JSantiagoGR/AquaHuerto-Escolar/epanet/3/reporte/img/F02_cajon_subida_y_cruz.jpg

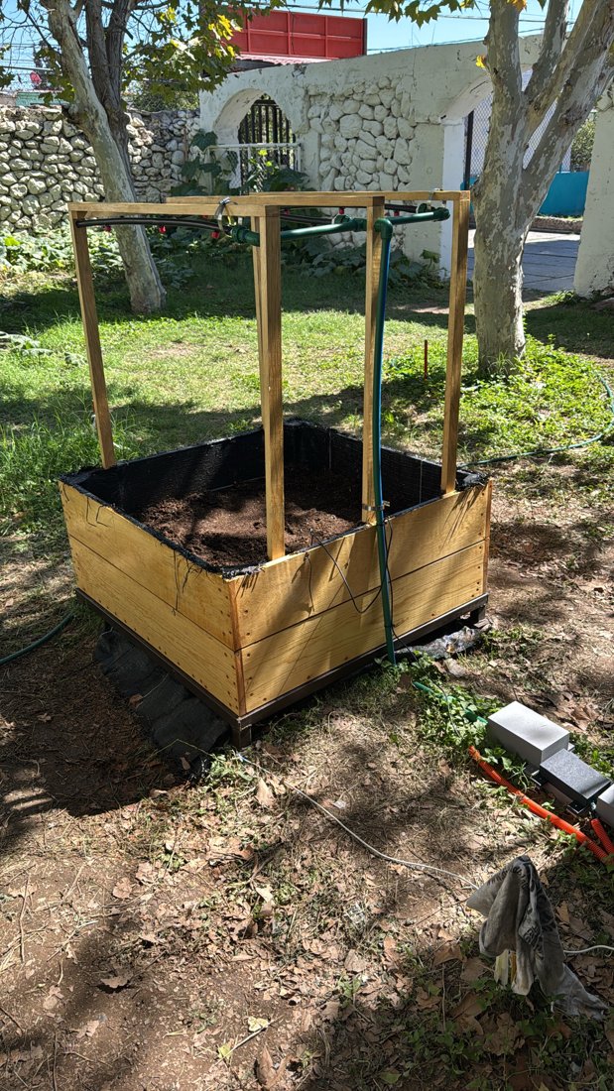
epanet/3/reporte/img/F02_cajon_subida_y_cruz.jpg
