JSantiagoGR/AquaHuerto-Escolar/epanet/1/datos_pendientes_validacion_final.md

# Datos pendientes para la validación final del modelo EPANET

El modelo `riego_huerto_final.inp` ya es ejecutable, pero sus **presiones** son preliminares. Estos datos deben medirse u obtenerse físicamente. Ordenados por impacto.

| # | Dato | Por qué importa | Cómo obtenerlo | Dónde se usa en EPANET |
|---|---|---|---|---|
| 1 | **Curva Q‑H real de la bomba** (≥ 3 puntos) | Fija la altura disponible y todas las presiones. La curva actual es PROVISIONAL. | Hoja técnica del fabricante; si no existe, **ensayo**: con la bomba a 12 V, medir caudal (probeta + cronómetro o YF‑S201) a varias presiones de descarga reguladas con una válvula de bola y un manómetro (0, 1, 2, 3 … bar hasta que corte el presostato). Registrar también el voltaje real. | `[CURVES]` → sustituir `PUMP_CURVE_PROVISIONAL` por `PUMP_CURVE_REAL` y actualizar `[PUMPS] PU1`. |
| 2 | **Modelo exacto de la bomba** | Permite buscar la curva certificada y la presión de arranque/corte del presostato. | Etiqueta completa, caja, factura o proveedor; número de modelo en el cuerpo o la cabeza de la bomba. | Documentación; fuente de la curva (#1). |
| 3 | **Nivel hidráulico del agua en el tinaco** (mín./máx.) | Es la altura de partida (Head de R1). | Medir con flexómetro la cota de la superficie del agua respecto a un datum común (p. ej., el suelo), con tinaco lleno y en nivel mínimo de operación. | `[RESERVOIRS] R1 Head` (o `[TANKS]` si se quiere modelar el vaciado). |
| 4 | **Altura del tinaco / de su salida** | Define la succión de la bomba (bomba autocebante ≈ 2.5 m según anuncios, no verificado). | Medir la cota de la salida del tinaco y de la bomba respecto al mismo datum. | Elevación de `J-PUMP` y Head de `R1`. |
| 5 | **Elevación del cajón** (superficie y goteros) | Determina la presión real en los goteros. | Medir cota de los laterales respecto al datum común. | `[JUNCTIONS]` Elev de `J-H`, `L1…L4` (y `E11…E46`). |
| 6 | **Diferencia de altura tinaco‑cajón** | Resume #3–#5; la presión en goteros cambia 1 m por cada metro de desnivel. | Resta de las cotas anteriores (o nivel de manguera con agua). | Diferencia entre `R1 Head` y Elev de nodos del cajón. |
| 7 | **Diámetro interior real de la manguera principal** | hf ∝ D^‑4.87: 1 mm menos en 12.7 mm aumenta la pérdida ≈ 50 % ((12.7/11.7)^4.87 = 1.49). Ahora se usa 12.7 mm nominal. | Calibrador vernier en un corte limpio (medir 2 direcciones y promediar) o especificación del fabricante. | `[PIPES] P-MAIN` Diam (mm); también `V1`. |
| 8 | **Diámetro interior real de la manguera de 16 mm** | “16 mm” es diámetro exterior nominal; el interior suele ser menor. | Vernier en un corte, o ficha técnica (espesor de pared). | `[PIPES] P-HEADER`, `PL1…PL4` (y segmentos del modelo 24). |
| 9 | **Pérdida hidráulica del YF‑S201** | Puede superar a toda la fricción de tuberías (≈ 1 cm calculado). | Ficha del sensor (curva ΔP‑Q) o ensayo: manómetro diferencial / dos manómetros antes y después a 1.6 L/min. Convertir a K = 2gΔh/V². | Añadir tramo corto o `MinorLoss` en el enlace aguas abajo de `J-FLOW`, o una TCV con K. |
| 10 | **Cv / Kv / K de la electroválvula** | Pérdida localizada en riego; hoy se modela como K = 0. | Hoja técnica (Kv en m³/h a 1 bar). K = 2g·(ΔP/ρg)/V² o desde Kv: ΔP[bar] = (Q[m³/h]/Kv)². Verificar también su **presión mínima de apertura** (muchas NC piloteadas requieren ≈ 0.2–0.5 bar; confirmar en la ficha). | Convertir `V1` en TCV con `Setting = K`, o `MinorLoss` en `V1`. |
| 11 | **Curva presión‑caudal de los goteros** | Los goteros reales cambian su caudal con la presión (salvo autocompensados). Con demandas fijas no se ve este efecto. | Ficha del gotero; o ensayo: recoger volumen de varios goteros en 5–10 min a 2–3 presiones distintas. | Define si se usan demandas fijas o emisores. |
| 12 | **Emitter coefficient de los goteros** | Permite simular goteros dependientes de presión: q = K·p^x. | De #11: ajustar K y x (EPANET usa `Emitter Exponent`, por defecto 0.5). Por gotero en L/s y m. | `[EMITTERS]` en `E11…E46` (modelo 24) y `[OPTIONS] Emitter Exponent`; eliminar la demanda fija. |
| 13 | Presión máxima admisible de goteros, conectores y manguera | Con la curva provisional la presión estimada es ≈ 67 m (≈ 6.6 bar); hay que confirmar si el sistema la resiste o requiere regulador. | Fichas técnicas de manguera, conectores y gotero. | Criterio de aceptación de resultados; eventual PRV en EPANET. |
| 14 | Pérdidas en accesorios (tee, adaptador 1/2 in → 16 mm, conectores de arranque) | Pérdidas menores no incluidas. | Tablas de K del fabricante o bibliografía de accesorios. | `MinorLoss` de los tramos correspondientes. |
| 15 | Caudal real medido con el YF‑S201 durante el riego | Validación final: comparar con 1.60 L/min del modelo. | Registro del ESP32 (pulsos/ s → L/min con el factor de calibración del sensor) y prueba volumétrica. | Comparación con Flow de `P-MAIN`. |

**Al recibir los datos:** editar el `.inp`, ejecutar `python validar_modelo.py riego_huerto_final.inp` y actualizar `calculos_hidraulicos.md` y `validacion_epanet.txt`.
