JSantiagoGR/AquaHuerto-Escolar/epanet/2/DECISIONS.md

# Decisiones de modelado y diseño

| # | Decisión | Motivo | Alternativa descartada |
|---|---|---|---|
| D1 | **DI = 14.40 mm** para todo el Tuboplus | Catálogo oficial Tuboplus 200224 (Clase 16, SDR 7.4) y Tabla 11 (v = 0.31 m/s a 0.05 L/s) lo confirman | 12.7 mm (“1/2"” nominal) |
| D2 | **Darcy‑Weisbach** (ε = 0.007 mm) como fórmula principal en EPANET | Los caudales son bajos: turbulento bajo (Re 4900–6500), transición (≈3200) y laminar (≈1600). H‑W no es válida en laminar/transición | H‑W (se reporta solo como comparación, C = 150) |
| D3 | Los 4 SD‑B como **EMITTERS individuales** (E1–E4), Q = C·Pⁿ con **n = 0.5827** ajustado a la tabla oficial de Hunter y C anclado en 50 L/h @ 1.5 bar | Hunter publica 3 puntos P‑Q (máximo ajuste) suficientes para el ajuste; no publica n | Una demanda equivalente; n = 0.5 como dato (se deja solo como escenario SUPUESTO) |
| D4 | Escenario adicional con **demanda fija** 50 L/h por aspersor | Obtener las pérdidas en el caudal de diseño y la **altura requerida de bomba (15.04 m a 0.0556 L/s)** sin depender de la curva provisional | — |
| D5 | **Check** = Pipe con **Status CV** (J‑TK → J‑CHK), K = 2.7 ESTIMADO | Es la representación EPANET de una válvula de retención; el sentido impide flujo bomba → tinaco | Válvula de control EPANET (no existe tipo “check”) |
| D6 | **Electroválvula** = Pipe ON/OFF (Status OPEN en riego) con K desde Kv = 3 (ESTIMADO) | Permite representar abierto/cerrado y una pérdida explícita; en v1 una TCV con K = 0 causó desbalance numérico | TCV con K inventado como real |
| D7 | **YF‑S201** = Pipe de D = 11 mm (DI documentado), L = 62 mm, K = 2.0 ESTIMADO | Representa la contracción del cuerpo; no hay curva ΔP‑Q del fabricante | Junction sin pérdida (v1) |
| D8 | Rama de cada aspersor = Pipe 30 mm, D = 4 mm (paso de la espiga de 6 mm, ESTIMADO), K = 1.0 | No ignorar el adaptador T‑rosca → espiga; es la mayor pérdida menor individual (0.139 m) | Conectar el emisor directamente al lateral |
| D9 | K de conexiones **oficiales Tuboplus (Tabla 10)**, asignados al enlace que entra a la conexión; T principal = tipo 8 (entra por derivación, sale por ambos lados, 2.20); T de aspersor = tee de rosca central (0.80) | Valores del fabricante | Convertir conexiones en “metros equivalentes de tubo” |
| D10 | **Bomba con curva PUMP_CURVE_PROVISIONAL** (la misma de v1: 91.91 m a Q = 0 → 0 m a 0.1 L/s, lineal) + sensibilidad ×0.25…×0.75 + altura requerida | No existe curva Q‑H verificable. **NO** se usa “6 L/min a 0.9 MPa” como punto simultáneo: 0.9 MPa se interpreta solo como corte del presostato a Q ≈ 0 | Inventar una curva “real” |
| D11 | Tinaco = **Reservoir** con Head = nivel de agua (1.19 m tinaco lleno); escenario con 0.30 m | Régimen permanente de riego; el tinaco se cambiará: todo se parametriza en `CONFIG["tinaco"]` | Tank (no aporta en estado estacionario) |
| D12 | Geometría: bomba cerca del tinaco (X ≈ 0.55 m), succión corta e inundada; subida a 5 cm del cajón; T dentro del cajón a 3 cm del borde | Succión corta y positiva (1.0 m) favorece el cebado; deja la línea principal en un solo tramo de 2.747 m | Bomba junto al cajón (succión larga) |
| D13 | Laterales **terminan en la T del aspersor B + niple 40 mm + tapón** (lateral c‑c ≈ 0.72 m, no 1.0 m) | Evita un tramo muerto de agua estancada sin aspersores y ahorra Tuboplus; los aspersores quedan en 0.25/0.75 m como se pidió | Prolongar el lateral hasta 1.0 m |
| D14 | Elevaciones: laterales +0.53 (sobre la tierra del cajón), boquilla +0.56 | Nivel de riego +0.52 dado por el equipo + radio del tubo + ~3 cm de tee/adaptador | — |
| D15 | Modelo **paramétrico** (`generar_modelo.py`, bloque CONFIG) | Permite sustituir tinaco, aspersor, curva de bomba, K y geometría y regenerar todo | Editar el .inp a mano |
| D16 | El servidor MCP se ejecutó con directorio de trabajo en una carpeta temporal | El servidor crea `Networks/` y `Modified/` en su directorio de trabajo; así no se modificaron las carpetas 1 ni 2 | Copiar archivos a la carpeta 1 |
| D17 | Capturas: `00_Modelo_Limpio.png` es captura **real** de la GUI de EPANET 2.2 (abierta por línea de comandos, captura de ventana sin interacción). Las vistas de resultados se generaron con Python (`*_PYTHON.png`) | En esta sesión no estaba disponible el control de la interfaz para pulsar Run Analysis ni cambiar vistas; no se inventan capturas | — |
| D18 | Filtro ≥ 100 mesh / 150 µm en el **esquema físico** (descarga de la bomba, antes del YF‑S201) y en el BOM, pero **no** en el modelo hidráulico base; el regulador tampoco | Hunter exige esa filtración; el modelo de filtro y su K no se conocen aún. Ubicado aguas abajo de la bomba para no añadir pérdida en la succión y proteger YF‑S201, electroválvula y SD‑B | Filtro antes de la bomba (pérdida en la succión de una bomba de diafragma) |
| D19 | Caudales de SD‑B fuera de 1.0–2.0 bar se reportan como **EXTRAPOLACIÓN DEL MODELO** (columna `nota` en los CSV y aviso del validador) | La tabla oficial de Hunter termina en 2.0 bar; 0.5–2.5 bar es solo el rango general de funcionamiento | Presentar 65.9 L/h como dato del aspersor |
| D20 | Se mantiene la distribución 0.25/0.75 m y se agrega un **escenario de cobertura r ≈ 0.36 m** (S9/S10) con presión obtenida por **interpolación** de la tabla oficial (≈ 1.80 bar, ≈ 56 L/h) | r = 0.30 m deja sin cubrir 9 puntos a 0.354 m; cambiar la distribución sin datos de campo no se justifica | Mover aspersores o inventar una relación radio‑presión |
