JSantiagoGR/AquaHuerto-Escolar/epanet/2/SOURCES.md

# Fuentes consultadas

Prioridad aplicada: fabricante > manual oficial > literatura técnica > otras fuentes. Consultadas entre el 29 y el 30 de septiembre de 2026.

| # | Fuente (URL) | Dato utilizado | Uso en el proyecto | Clase |
|---|---|---|---|---|
| 1 | Rotoplas, *Manual Técnico Tuboplus* (ed. 2017) — https://ferreambriz.com/wp-content/uploads/2024/08/MANUAL-TUBOPLUS.pdf | Catálogo de tubos: código **200224**, d 20, **di 14.40 mm, e 2.80 mm, área 1.63 cm²**; marcado “Clase 16 (SDR 7.4)”; **rugosidad 0.007 mm**; viscosidad 1.02×10⁻⁶ m²/s; **Tabla 10 de coeficientes K** (codo 90° 2.00, tee 1.8/1.3/4.2/2.2, tee rosca central 0.80, conector 0.40, reducción 0.55/0.85, cople 0.25); **Tabla 11** (0.05 L/s → j 0.013 m/m, v 0.31 m/s); dimensiones de codo 200014, tee 200178, tee rosca central 2000166, conector 200039/200051, tuerca unión mixta 200235, tapón 200155 | Diámetro interior en EPANET, rugosidad D‑W, K de conexiones, cortes y validación cruzada de la fórmula de fricción | OFICIAL (manual del fabricante; copia alojada por distribuidor) |
| 2 | Rotoplas Centroamérica, *Tuboplus Hidráulico (PP‑R) — Especificaciones técnicas* — https://rotoplascentroamerica.com/tuboplus/rtp-resources/descargas/Final_Ficha_Tecnica_Tuboplus_Impresioon.pdf | 24 kg/cm² a 20 °C; tiempos de termofusión 20 mm (12 s / 4 s / 2 min); presiones admisibles | BOM (instalación), límite de presión | OFICIAL |
| 3 | Rotoplas México, producto “Tubo clase 16 de 20 mm” — https://rotoplas.com.mx/product/Tubo-clase-16-de-20-mm-Tuboplus/ | SKU **200224**, clase 16, 20 mm (1/2") | Confirma que el tubo comercial de 1/2" es el código del catálogo con DI 14.40 mm | OFICIAL |
| 4 | Ficha técnica Tuboplus (conducción de agua) — https://pprmexico.com/wp-content/uploads/2025/02/tuboplus-ficha-tecnica.pdf | Conectores con inserto (20 × 1/2", NPT), tuercas unión plásticas, par máx. 16 N·m | BOM / instalación | OFICIAL (alojada por distribuidor) |
| 5 | Hunter Industries, *Micro Sprays Product Cutsheet (Metric)* — https://www.hunterirrigation.com/sites/default/files/CA-Cutsheet-Micro-Sprays-EM.pdf | Solo‑Drip: 1.0 bar 0–40 L/h Ø0–0.5 m; **1.5 bar 0–50 L/h Ø0–0.6 m**; 2.0 bar 0–60 L/h Ø0–0.8 m; ajustable (~20 clics); **entrada espiga 6 mm**; **rango 0.5–2.5 bar**; **filtración mínima 100 mesh / 150 µm** | Escenario de diseño (50 L/h a 1.5 bar), ajuste del emisor Q = C·Pⁿ, verificación de rango, filtro en BOM | OFICIAL |
| 6 | Hunter, *Micro Sprays Performance Charts* (métrico) — https://www.hunterirrigation.com/en-metric/node/32276 ; (US) https://www.hunterirrigation.com/node/32276 | Misma tabla de desempeño (US: 15/20/30 psi → 11/12.5/15.7 GPH) | Confirmación cruzada | OFICIAL |
| 7 | Hunter, página del SD‑B — https://www.hunterirrigation.com/en-metric/irrigation-product/micro-sprays/sd-b | SKU **SDB**, “Barb, 360°”, UPC 0611698156742 | Identificación del modelo provisional | OFICIAL |
| 8 | Handson Technology, *YF‑S201B Water Flow Sensor User Guide* — https://handsontec.com/dataspecs/sensor/Water%20Flow%20Sensor.pdf | **DI 11 mm**, DE 20 mm, 1–30 L/min, presión de prueba < 1.75 MPa, 450 pulsos/L, ±5 % (2–30 L/min) | D del enlace YF en EPANET; rango de operación | DOC. TÉCNICA de distribuidor (no hay fabricante identificado) |
| 9 | Ficha YF‑S201 (distribuidor) — https://fabacademy.org/2025/labs/dilijan/students/zhirayr-ghukasyan/files/Week09/YF-S201.PDF | F (Hz) = 7.5·Q (L/min); presión máx. 2.0 MPa; conexiones 1/2" | Frecuencia esperada (25 Hz a 3.33 L/min) | DOC. TÉCNICA de distribuidor |
| 10 | Anuncios comerciales de la bomba (eBay https://www.ebay.com/itm/296626432825 ; AliExpress https://www.aliexpress.com/item/1005005564374311.html ; Amazon/Walmart) | Solo repiten la placa: 12 V, 6 A, 72 W, 6 L/min, 0.9 MPa; **ninguno publica curva Q‑H** | Justifica que la curva es PROVISIONAL; **no** se usó como curva | COMERCIAL (no confiable para curva) |
| 11 | Crane Co., *Flow of Fluids Through Valves, Fittings, and Pipe*, Technical Paper 410 | K de válvula check de columpio = 100·f_T; f_T(1/2") = 0.027 → **K ≈ 2.7**; check de elevación K = 600·f_T ≈ 16.2; entrada de borde vivo K = 0.5 | K ESTIMADO de la check y de la salida del tinaco; rango de sensibilidad | LITERATURA TÉCNICA |
| 12 | IEC 60534 / VDI/VDE 2173 (definición de Kv) | Kv = Q[m³/h] a Δp = 1 bar → Δp = (Q/Kv)² | Conversión Kv → K de la electroválvula | NORMA / LITERATURA |
| 13 | U.S. EPA, *EPANET 2.2 User Manual* (EPA/600/R‑20/133) — https://www.epa.gov/system/files/documents/2021-07/epanet_users_manual_2.2.0-1.pdf | Formato .INP, unidades LPS, D‑W con interpolación en transición, emisores Q = C·pⁿ (exponente global), Pipe con Status CV (check) | Construcción del modelo | OFICIAL |
| 14 | OpenWaterAnalytics EPANET / EPyT — https://github.com/OpenWaterAnalytics/EPANET , https://github.com/OpenWaterAnalytics/EPyT | Toolkit 2.3.5 (doble precisión) | Escenarios y validación cruzada | OFICIAL (código abierto) |
| 15 | USEPA / Sandia WNTR 1.5 — https://github.com/USEPA/WNTR | Parser + EpanetSimulator v2.2 | Validación, grafo, figuras | OFICIAL (código abierto) |
| 16 | KWR‑Water, *epanet-mcp-server* — https://github.com/KWR-Water/epanet-mcp-server | Servidor MCP “EPANET Simulation Server” 1.30.0 | Simulación vía MCP (validación adicional) | Código abierto |
| 17 | Swamee & Jain (1976), *J. Hydraulics Div. ASCE* 102(5); Colebrook (1939) | Ecuaciones de factor de fricción | Cálculo manual | LITERATURA |
| 18 | Material de clase `Epanet 2.pptx` (carpeta 1 / Descargas) | Fórmulas H‑W, D‑W, Re, Moody, LPS | Método de cálculo | CLASE |
