JSantiagoGR/AquaHuerto-Escolar/documentacion/EXPOSICION_AquaHuerto/00_Indice_general.docx

AQUAHUERTO ESCOLAR

Índice general de la carpeta

Dónde está cada documento solicitado

Sistema mecatrónico de riego inteligente para huertos escolares

Escuela Primaria Federal Belisario Domínguez · Chihuahua, Chihuahua

Equipo 2 · Tecnológico de Monterrey, Campus Chihuahua

Jaime Santiago Galaviz Reaza

Victor Manuel Palicio Torres

Eyra Cristal Garcia

Noviembre de 2026

# Contenido de la carpeta

# | Documento | Carpeta

1 | Anteproyecto de Ingenierías (Anexo 2) | 1_Documentos_principales/01_Anteproyecto_Anexo2
2 | Bitácora del proyecto | 1_Documentos_principales/02_Bitacora_del_proyecto
3 | Cartel científico | 1_Documentos_principales/03_Cartel_cientifico
4 | Bibliografía y referencias | 1_Documentos_principales/04_Bibliografia_y_referencias
5 | Memoria técnica | 2_Documentacion_tecnica/05_Memoria_tecnica (+ reporte y manuales técnicos)
6 | Planos y modelos CAD | 2_Documentacion_tecnica/06_Planos_CAD (+ modelos 3D: SolidWorks, STEP, STL y Blender)
7 | Diagramas hidráulicos | 2_Documentacion_tecnica/07_Diagramas_hidraulicos
8 | Simulaciones de EPANET | 2_Documentacion_tecnica/08_EPANET (+ modelo .inp y resultados)
9 | Diagrama eléctrico y electrónico | 2_Documentacion_tecnica/09_Diagrama_electrico
10 | Especificaciones de componentes | 2_Documentacion_tecnica/10_Especificaciones_componentes
11 | Diagramas de flujo y arquitectura | 2_Documentacion_tecnica/11_Diagramas_flujo_y_arquitectura
12 | Firmware ESP32 y modos | 2_Documentacion_tecnica/12_Firmware_ESP32
13 | Dashboard, MQTT, Node-RED y Raspberry Pi | 2_Documentacion_tecnica/13_Dashboard_MQTT_NodeRED_RaspberryPi
14 | Modelo de IA predictiva | 2_Documentacion_tecnica/14_Modelo_IA
15 | Calibración de sensores | 2_Documentacion_tecnica/15_Calibracion_sensores
16 | Pruebas físicas | 2_Documentacion_tecnica/16_Pruebas_fisicas (+ datos crudos)
17 | Comparación contra objetivos | 2_Documentacion_tecnica/17_Comparacion_contra_objetivos
18 | Riesgos y seguridad | 2_Documentacion_tecnica/18_Analisis_de_riesgos
19 | Fotografías del proceso | 2_Documentacion_tecnica/19_Fotografias
20 | Cartel para imprimir | 3_Exhibicion/20_Cartel_para_imprimir
21 | Bitácora para evaluadores | 3_Exhibicion/21_Bitacora_para_evaluadores
22 | Demostración segura | 3_Exhibicion/22_Demostracion_segura
23 | Fotografías, gráficas y videos | 3_Exhibicion/23_Fotos_graficas_y_videos
24 | Explicación oral de 15 minutos | 3_Exhibicion/24_Explicacion_oral_15_min

Cada documento está en Word (para editar) y en PDF (para imprimir o entregar).

# Lo que deben agregar ustedes

- Videos del riego real y de la demostración (carpeta 23).
- Fotos de la construcción que tengan en sus celulares (carpeta 19).
- Si la convocatoria da un formato oficial del Anexo 2 o medidas del cartel distintas a 90 × 120 cm, pasar el contenido a ese formato.

AquaHuerto · Índice general de la carpeta · Página
