JSantiagoGR/AquaHuerto-Escolar/documentacion/EXPOSICION_AquaHuerto/2_Documentacion_tecnica/06_Planos_CAD/modelos_3D/renders/bomba_de_cerca.png

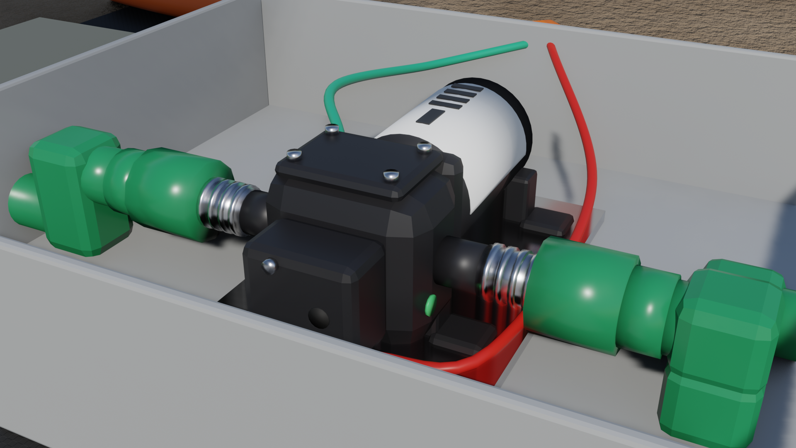
documentacion/EXPOSICION_AquaHuerto/2_Documentacion_tecnica/06_Planos_CAD/modelos_3D/renders/bomba_de_cerca.png
