JSantiagoGR/AquaHuerto-Escolar/documentacion/EXPOSICION_AquaHuerto/2_Documentacion_tecnica/08_EPANET/capturas/fig_epanet_presiones.png

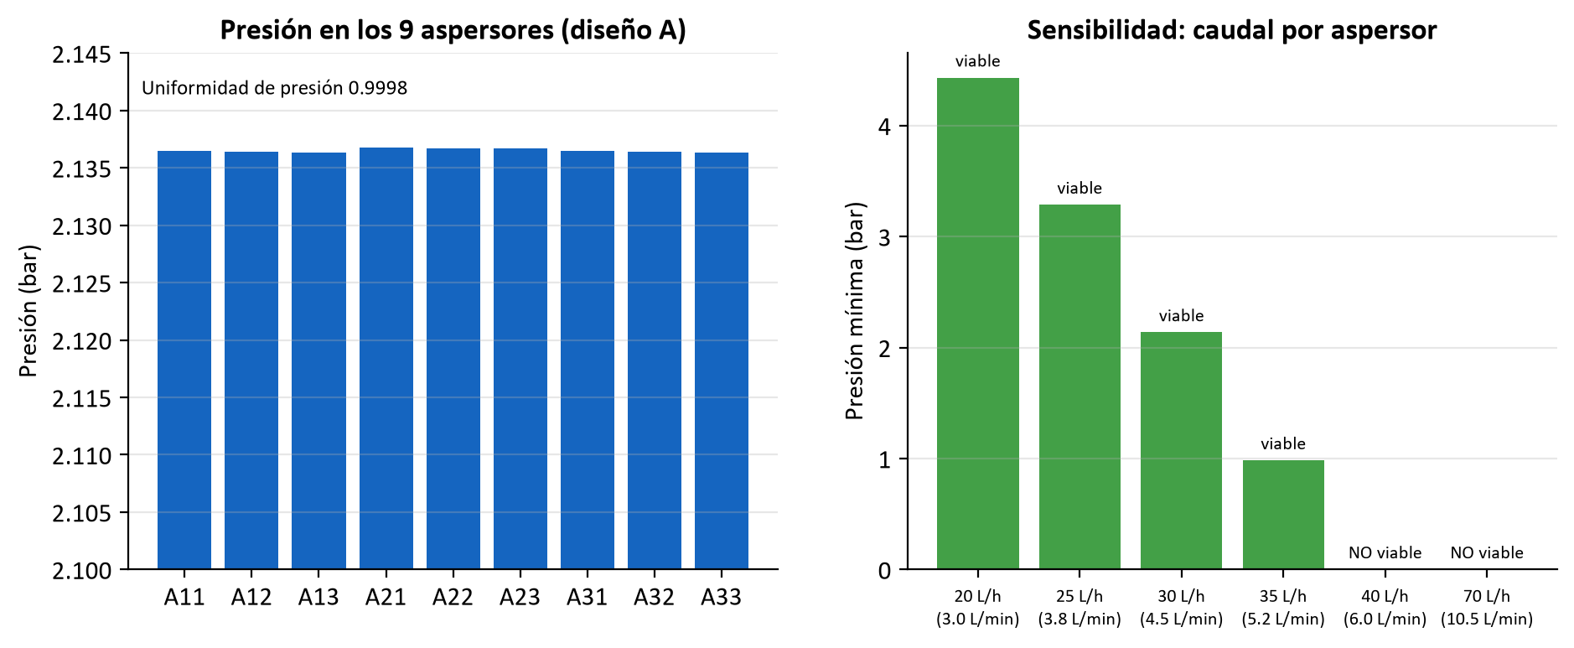
documentacion/EXPOSICION_AquaHuerto/2_Documentacion_tecnica/08_EPANET/capturas/fig_epanet_presiones.png
