JSantiagoGR/AquaHuerto-Escolar/documentacion/EXPOSICION_AquaHuerto/2_Documentacion_tecnica/13_Dashboard_MQTT_NodeRED_RaspberryPi/capturas_dashboard/d_automatico.jpg

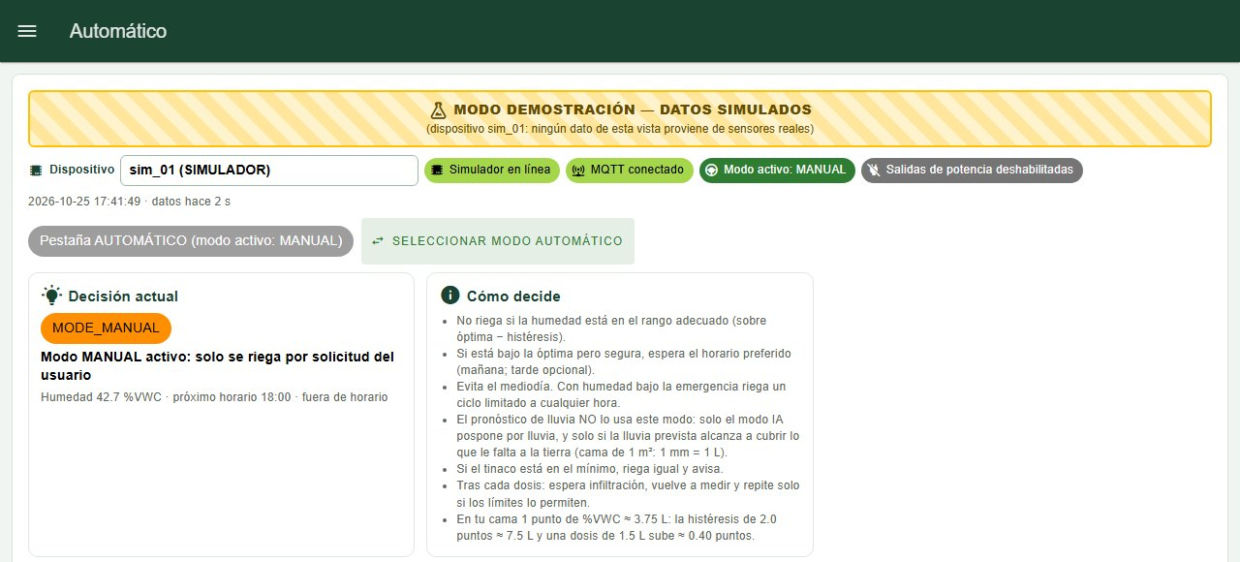
documentacion/EXPOSICION_AquaHuerto/2_Documentacion_tecnica/13_Dashboard_MQTT_NodeRED_RaspberryPi/capturas_dashboard/d_automatico.jpg
