JSantiagoGR/AquaHuerto-Escolar/documentacion/EXPOSICION_AquaHuerto/2_Documentacion_tecnica/19_Fotografias/4_Seleccion_para_presentacion/f_caudalimetro.jpg

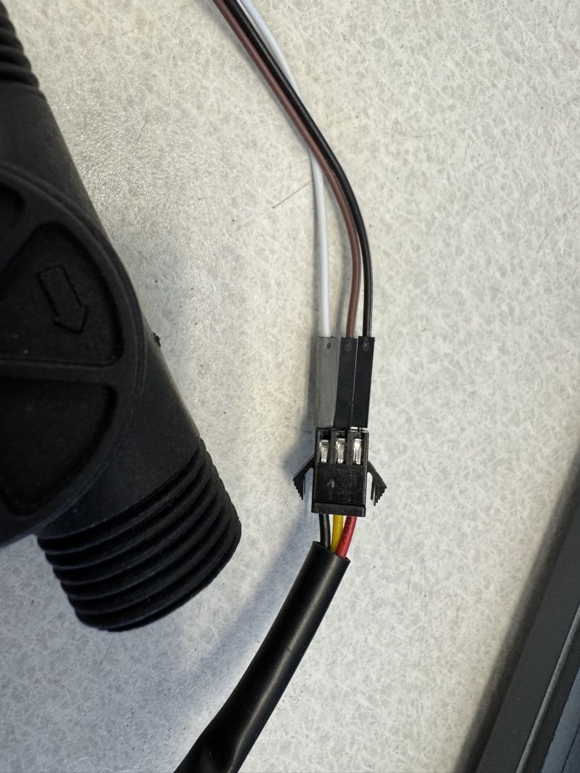
documentacion/EXPOSICION_AquaHuerto/2_Documentacion_tecnica/19_Fotografias/4_Seleccion_para_presentacion/f_caudalimetro.jpg
