JSantiagoGR/AquaHuerto-Escolar/documentacion/EXPOSICION_AquaHuerto/3_Exhibicion/23_Fotos_graficas_y_videos/graficas_y_diagramas/fig_datos_reales_huerto.png

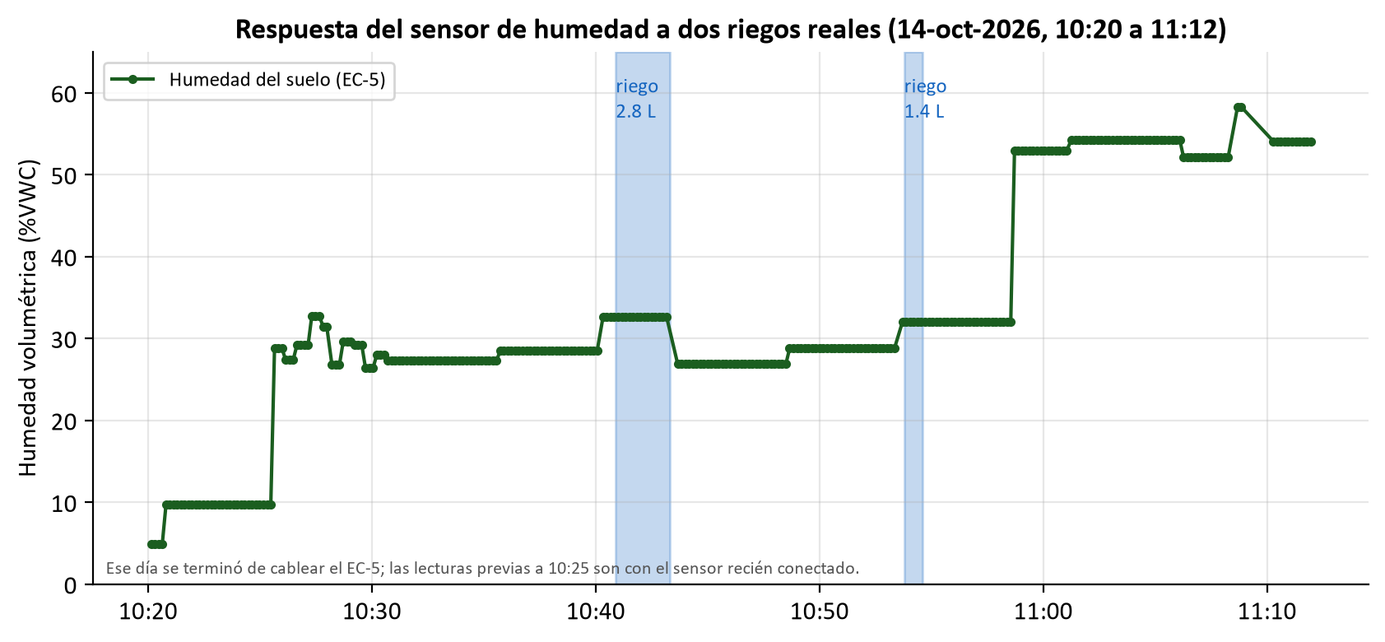
documentacion/EXPOSICION_AquaHuerto/3_Exhibicion/23_Fotos_graficas_y_videos/graficas_y_diagramas/fig_datos_reales_huerto.png
