JSantiagoGR/AquaHuerto-Escolar/documentacion/EXPOSICION_AquaHuerto/_generador/figuras/comp_dht.jpg

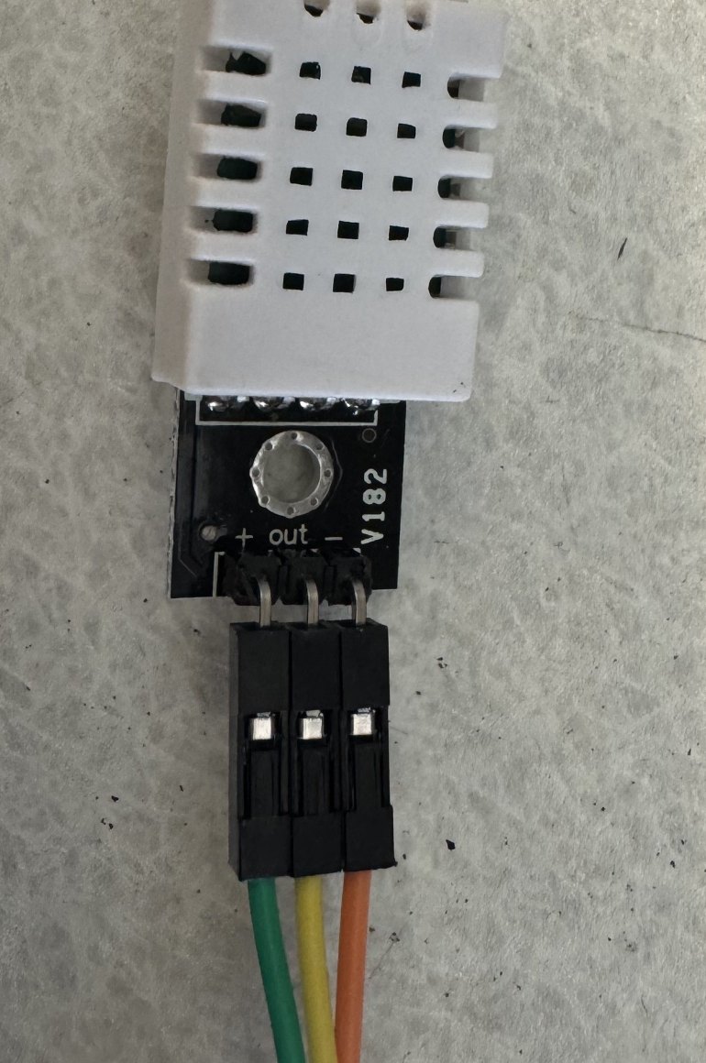
documentacion/EXPOSICION_AquaHuerto/_generador/figuras/comp_dht.jpg
