JSantiagoGR/AquaHuerto-Escolar/documentacion/EXPOSICION_AquaHuerto/_generador/figuras/comp_esp32.jpg

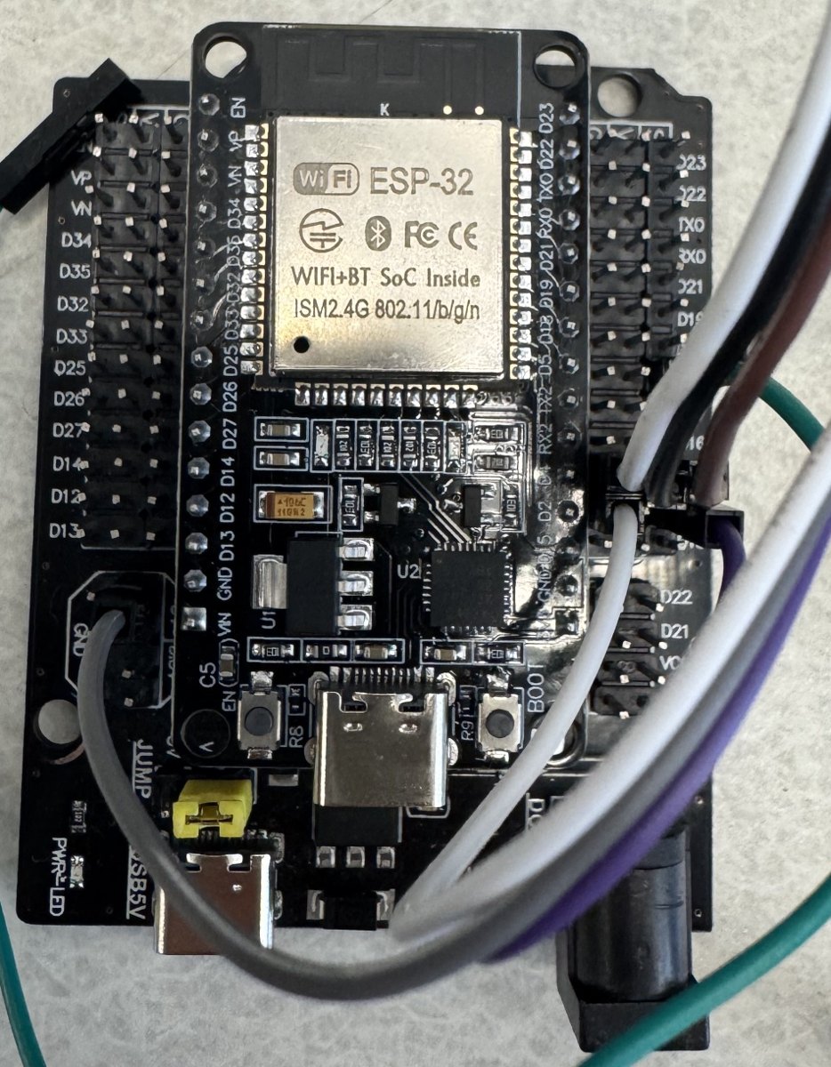
documentacion/EXPOSICION_AquaHuerto/_generador/figuras/comp_esp32.jpg
