JSantiagoGR/AquaHuerto-Escolar/documentacion/EXPOSICION_AquaHuerto/_generador/figuras/comp_reles.jpg

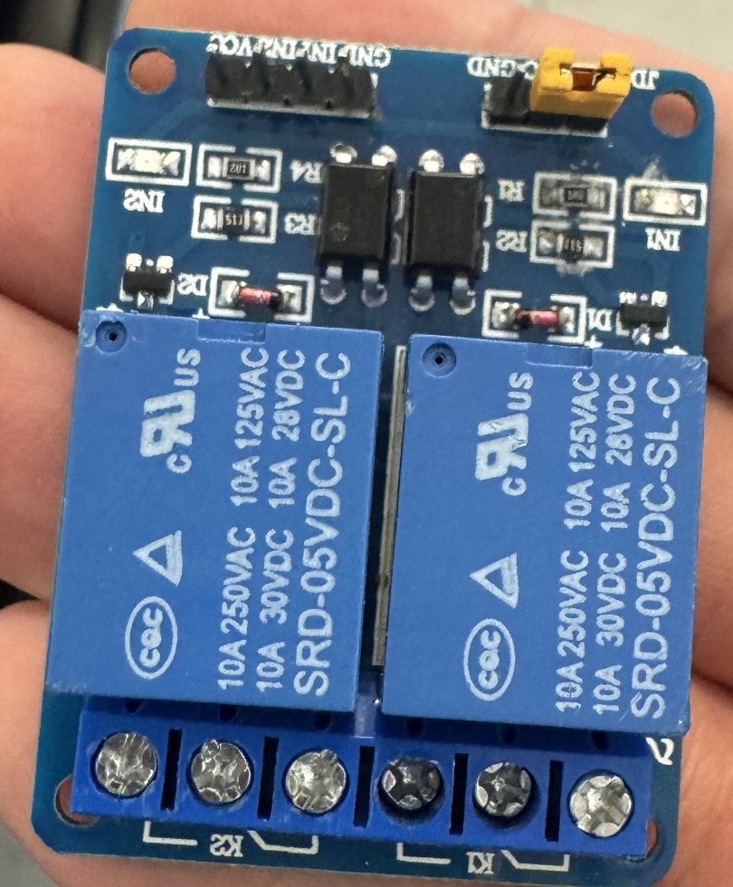
documentacion/EXPOSICION_AquaHuerto/_generador/figuras/comp_reles.jpg
