JSantiagoGR/AquaHuerto-Escolar/documentacion/EXPOSICION_AquaHuerto/_generador/figuras/comp_valvula.jpg

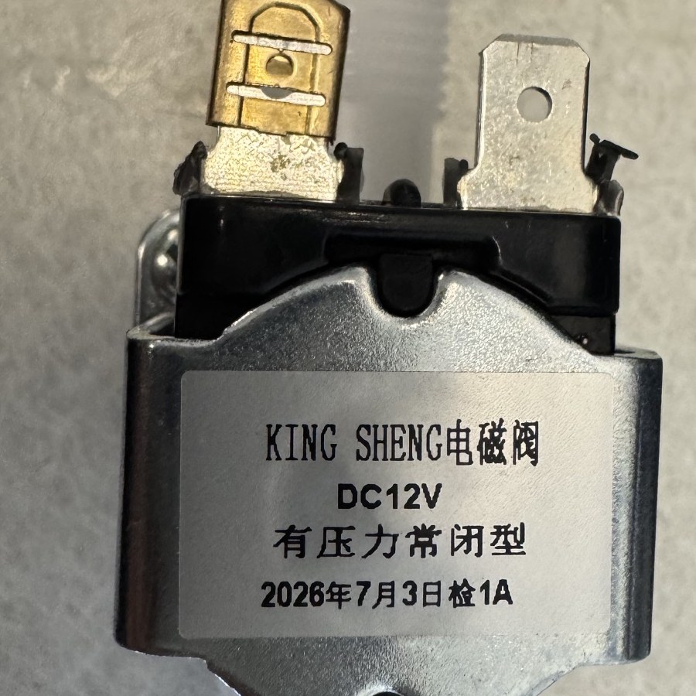
documentacion/EXPOSICION_AquaHuerto/_generador/figuras/comp_valvula.jpg
