JSantiagoGR/AquaHuerto-Escolar/documentacion/EXPOSICION_AquaHuerto/_generador/figuras/diseno_image2.png

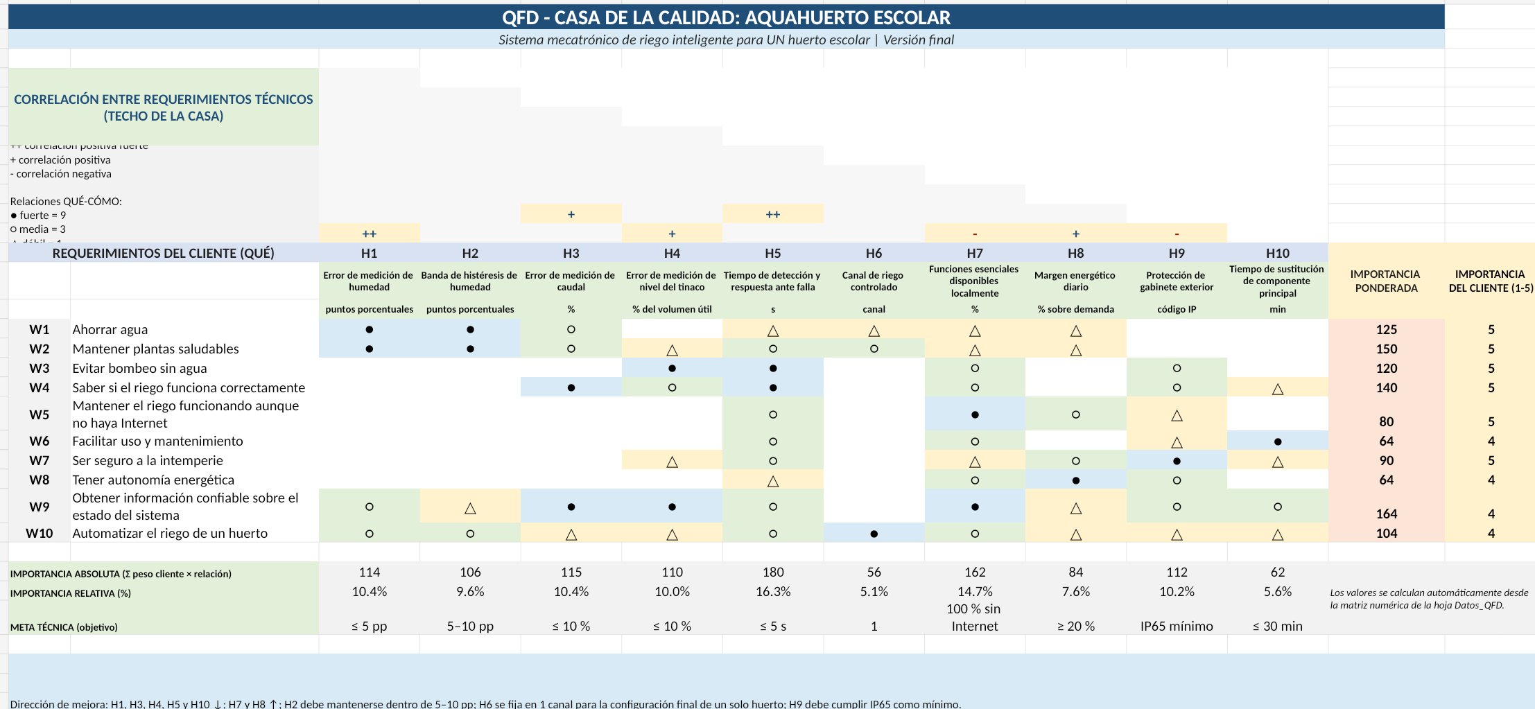
documentacion/EXPOSICION_AquaHuerto/_generador/figuras/diseno_image2.png
