JSantiagoGR/AquaHuerto-Escolar/documentacion/EXPOSICION_AquaHuerto/_generador/figuras/diseno_image3.png

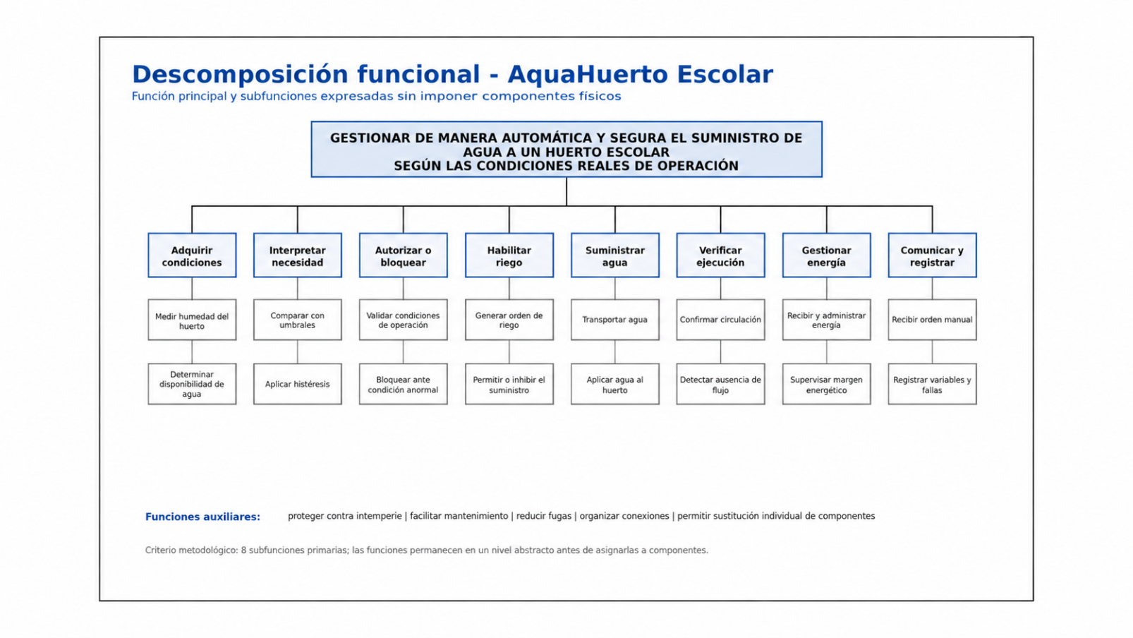
documentacion/EXPOSICION_AquaHuerto/_generador/figuras/diseno_image3.png
