JSantiagoGR/AquaHuerto-Escolar/documentacion/EXPOSICION_AquaHuerto/_generador/figuras/diseno_image7.png

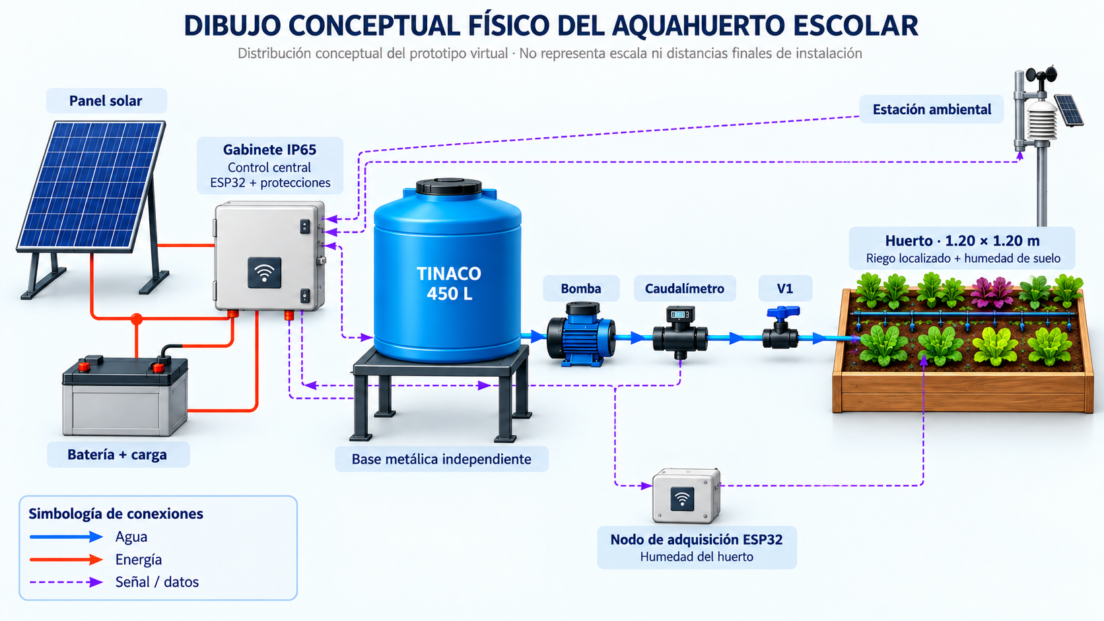
documentacion/EXPOSICION_AquaHuerto/_generador/figuras/diseno_image7.png
