JSantiagoGR/AquaHuerto-Escolar/documentacion/EXPOSICION_AquaHuerto/_generador/figuras/diseno_image8.png

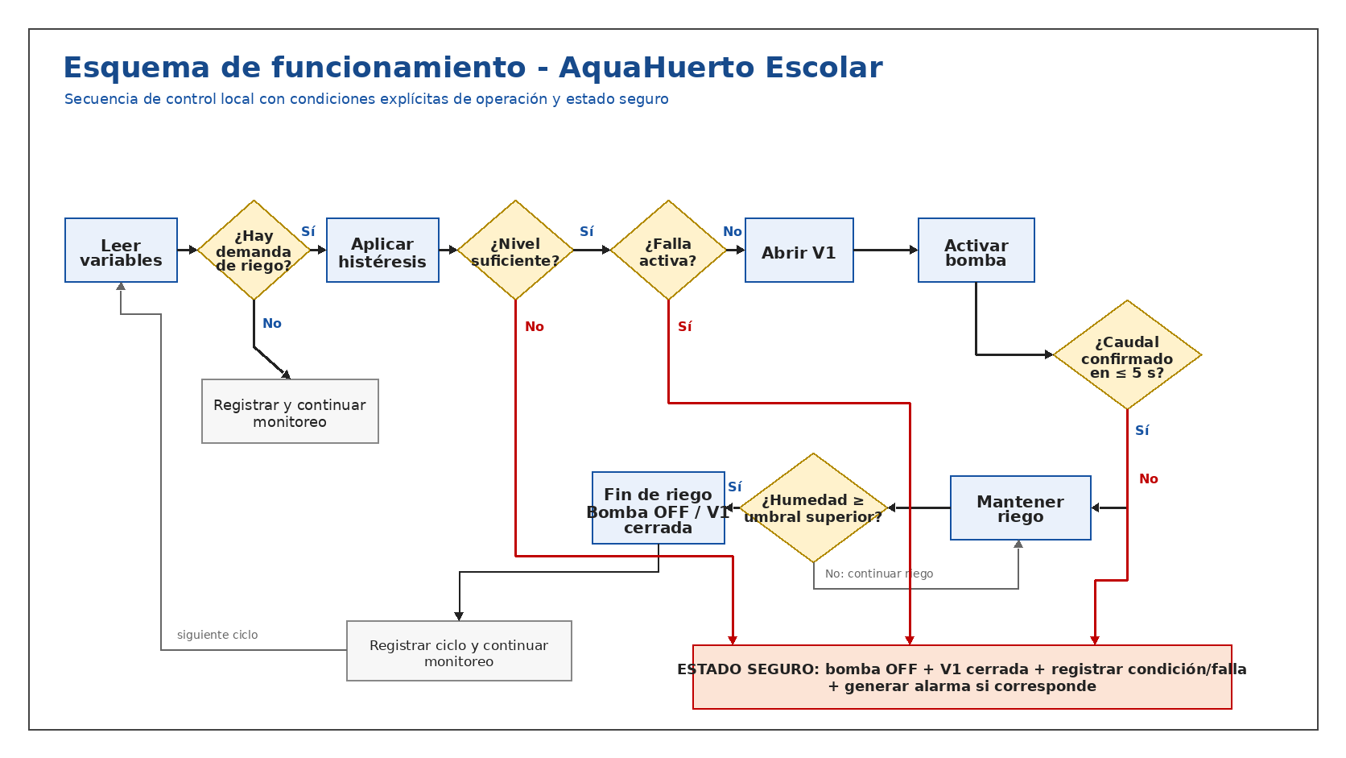
documentacion/EXPOSICION_AquaHuerto/_generador/figuras/diseno_image8.png
