JSantiagoGR/AquaHuerto-Escolar/documentacion/reporte/img/banda_humedad.png

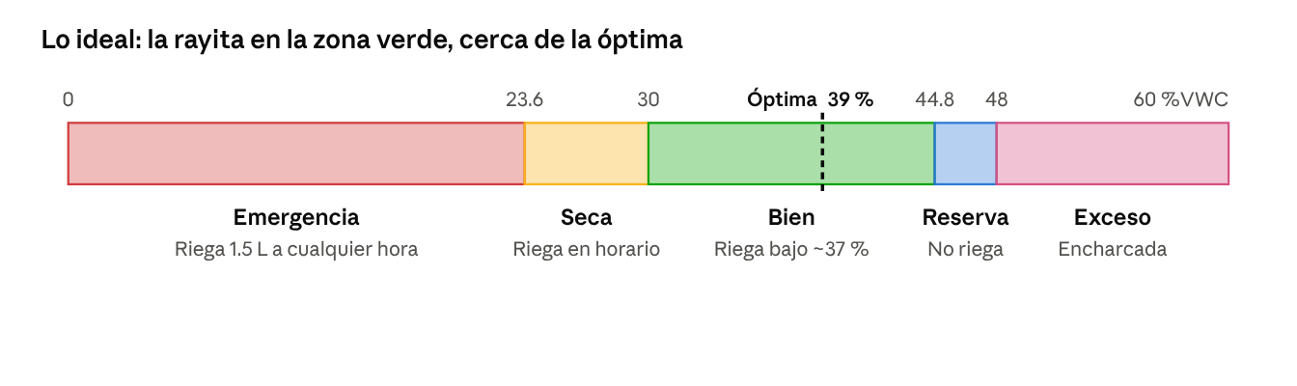
documentacion/reporte/img/banda_humedad.png
