JSantiagoGR/AquaHuerto-Escolar/epanet/2/capturas_epanet/00_Modelo_Limpio.png

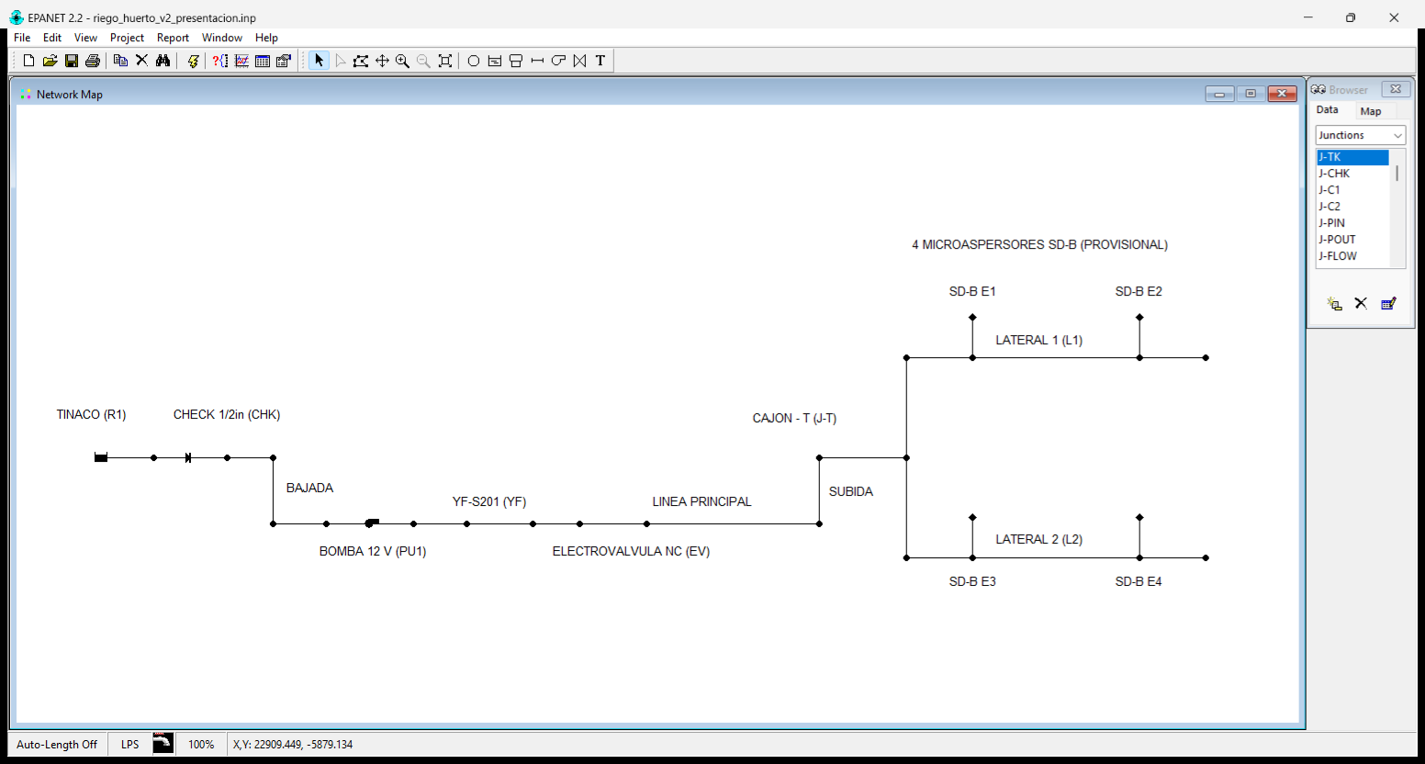
epanet/2/capturas_epanet/00_Modelo_Limpio.png
