JSantiagoGR/AquaHuerto-Escolar/epanet/2/capturas_epanet/01_Pressure_Flow_PYTHON.png

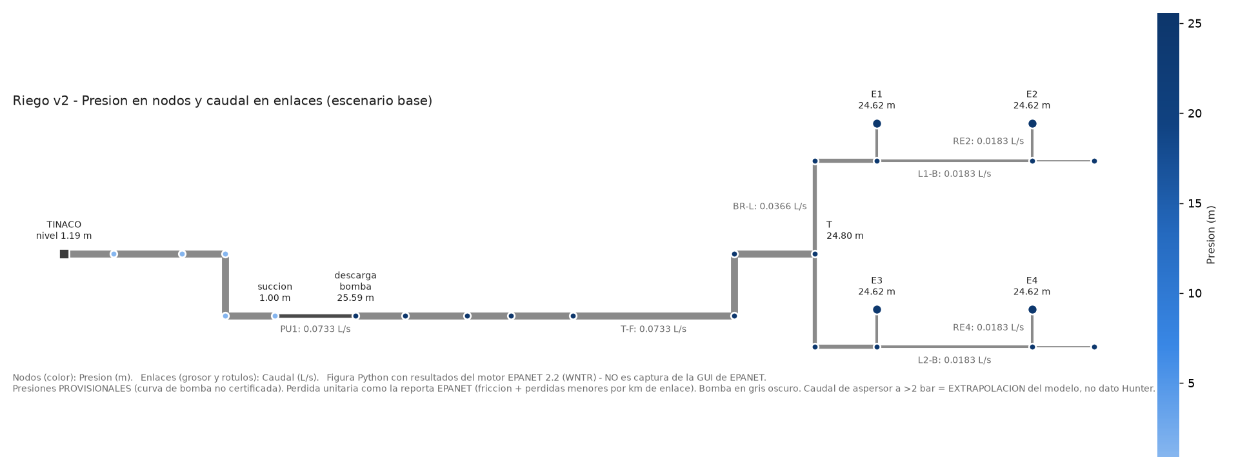
epanet/2/capturas_epanet/01_Pressure_Flow_PYTHON.png
