JSantiagoGR/AquaHuerto-Escolar/epanet/2/capturas_epanet/04_Cobertura_PYTHON.png

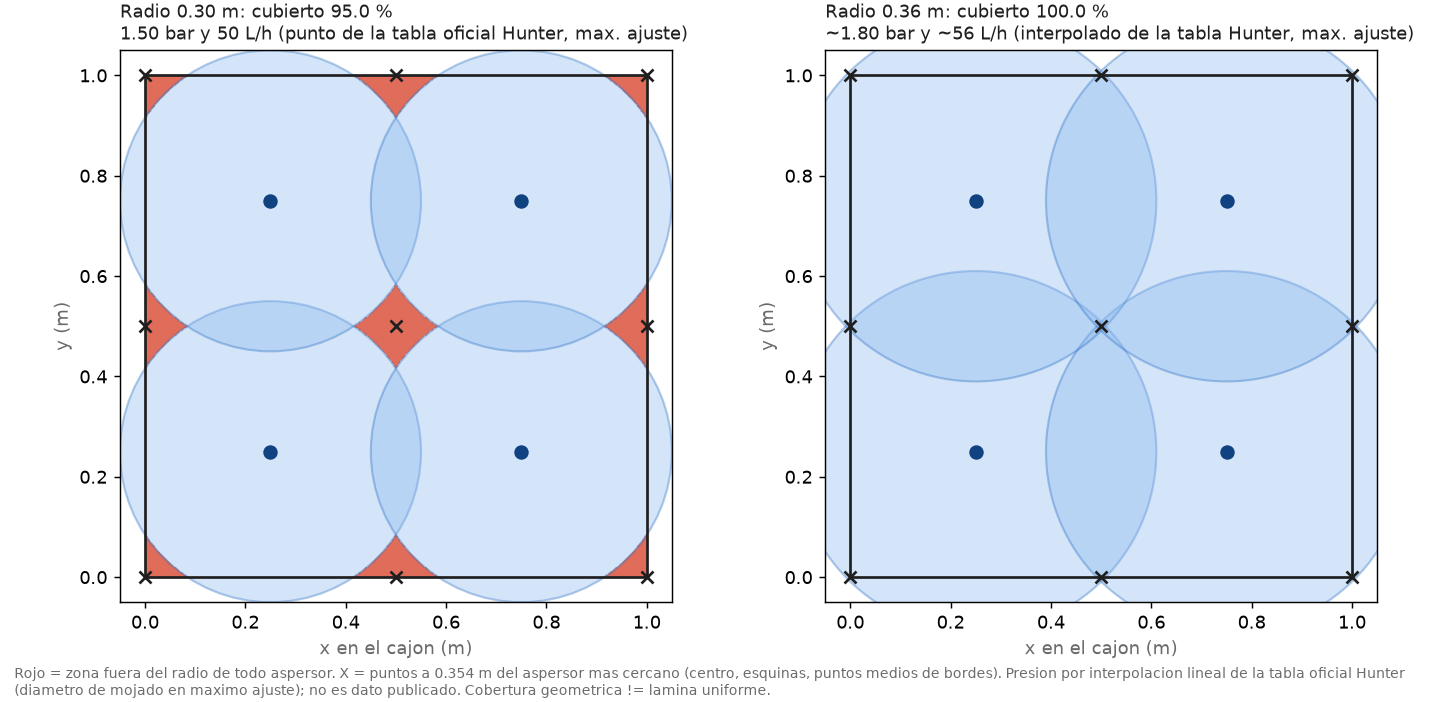
epanet/2/capturas_epanet/04_Cobertura_PYTHON.png
