JSantiagoGR/AquaHuerto-Escolar/epanet/3/fotos_reales/F05_caja_bomba_frente.jpg

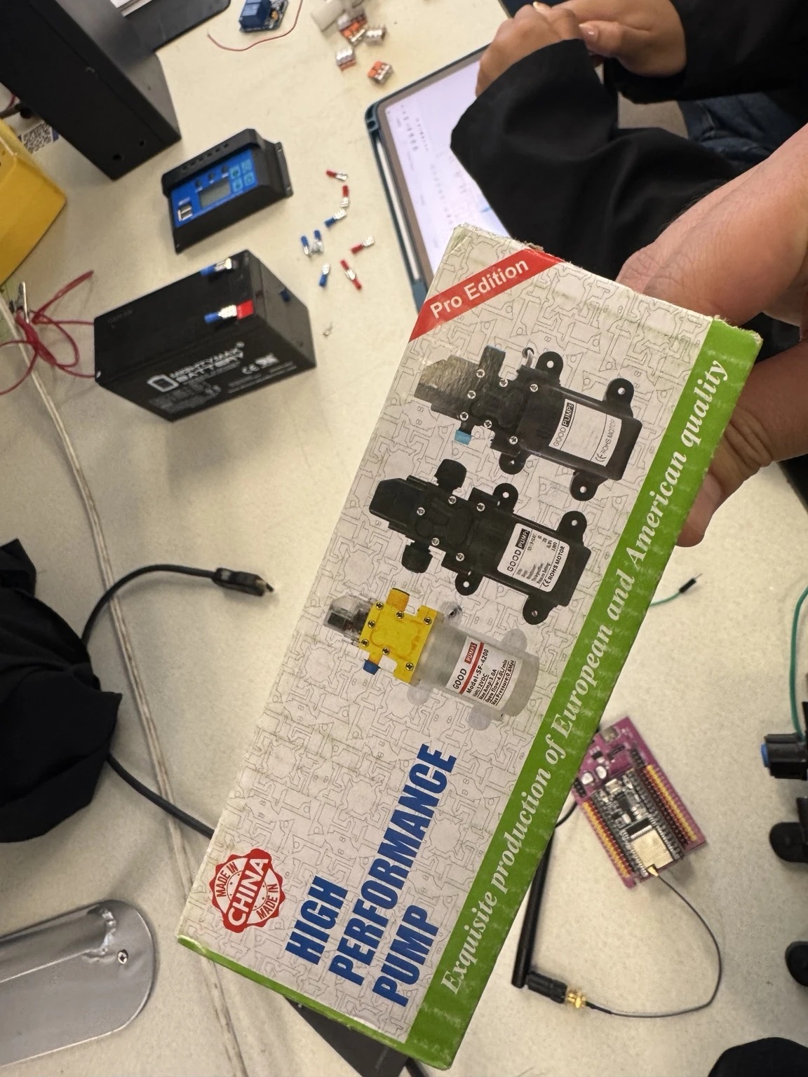
epanet/3/fotos_reales/F05_caja_bomba_frente.jpg
