JSantiagoGR/AquaHuerto-Escolar/epanet/3/reporte/img/F07_caja_bomba_lateral.jpg

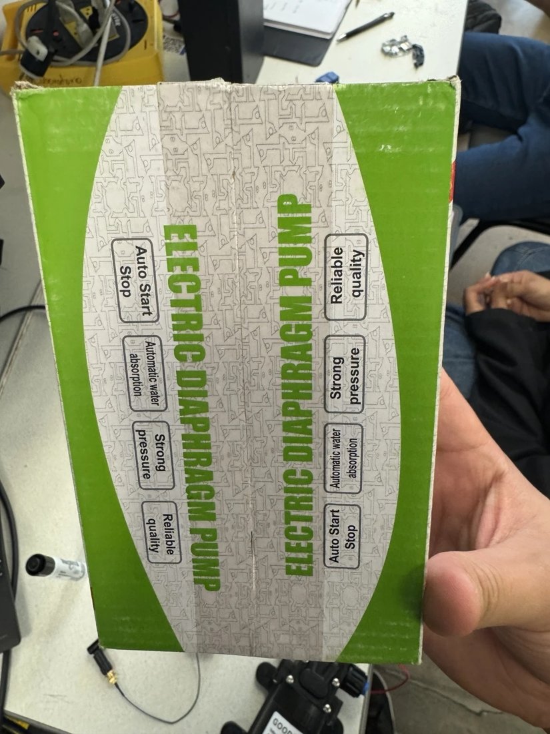
epanet/3/reporte/img/F07_caja_bomba_lateral.jpg
