JSantiagoGR/AquaHuerto-Escolar/epanet/2/BOM_hidraulico.csv

componente | cantidad | medida | función | conexión | modelo | estado | observaciones
Tubo Tuboplus hidráulico PP-R Clase 16 | 2 | 20 mm (1/2") x 4.00 m; DE 20.0 / e 2.80 / DI 14.40 mm | Conducción de todo el sistema | Termofusión | Rotoplas Tuboplus código 200224 | CONFIRMADO | DI 14.40 mm OFICIAL (Manual Tuboplus). Se usan 5.722 m de 8.00 m (ver tabla_cortes_tuboplus.csv)
Codo 90° Tuboplus | 6 | 20 mm | Bajada (2) + subida (2) + entrada a laterales (2) | Termofusión | Tuboplus 200014 (L 27 / p 15 mm) | CONFIRMADO | K = 2.00 OFICIAL (Tabla 10)
T normal Tuboplus (distribución centrada) | 1 | 20 mm | Divide el flujo a lateral 1 y lateral 2 (entrada por la derivación) | Termofusión | Tuboplus 200178 (L 54 / L1 27 / p 16 mm) | CONFIRMADO | K = 2.20 OFICIAL (Tabla 10 No. 8)
T con rosca central hembra Tuboplus | 4 | 20 x 1/2" | Toma de cada microaspersor sobre el lateral | Termofusión + rosca hembra 1/2" NPT | Tuboplus 2000166 (L 54 / L1 33 / p 16 mm) | CONFIRMADO | K = 0.80 OFICIAL (Tabla 10 No. 9); rosca NPT según manual
Tapón Tuboplus | 2 | 20 mm | Cierre al final de cada lateral | Termofusión | Tuboplus 200155 (L 20 / p 16 mm) | CONFIRMADO | Con niple de 40 mm de Tuboplus entre la tee y el tapón
Conector macho Tuboplus | 1 | 20 x 1/2" | Unión del Tuboplus con la salida de la válvula check | Termofusión + rosca macho 1/2" NPT | Tuboplus 200051 (L 53 / p 16 mm) | CONFIRMADO | K = 0.40 OFICIAL; confirmar rosca de la check
Conector hembra Tuboplus | 4 | 20 x 1/2" | Entrada/salida del YF-S201 (2) y de la electroválvula (2) | Termofusión + rosca hembra 1/2" NPT | Tuboplus 200039 (L 53 / p 16 mm) | PROVISIONAL | K = 0.40 OFICIAL. YF-S201 tiene rosca macho G1/2 (BSPP); revisar compatibilidad NPT/BSP y sellado; electroválvula: confirmar si es macho o hembra
Tuerca unión mixta Tuboplus (unión desmontable) | 2 | 20 x 1/2" | Permite desmontar la bomba (succión y descarga) | Termofusión + rosca 1/2" NPT con O-ring | Tuboplus 200235 (L 46 / p 16 mm) | CONFIRMADO | Unión desmontable; K tomado como conector 0.40
Adaptador Tuboplus 1/2" <-> puerto de bomba | 2 | 1/2" <-> rosca de bomba (OD medido 16-17 mm) | Reducción/ampliación hacia los puertos de la bomba | Rosca | adaptador Tuboplus 1/2" ↔ puerto bomba, estándar de rosca pendiente | PENDIENTE | OD 16-17 mm medido es compatible con 3/8" (BSP 16.66 / NPT 17.1) pero NO se asume; K 0.55 (reducción) y 0.85 (ampliación) OFICIAL Tuboplus
Niple / adaptador salida del tinaco | 1 | 1/2" (según salida del tinaco) | Une la salida del tinaco con la válvula check | Rosca | Según tinaco definitivo | PENDIENTE | El tinaco actual es PROVISIONAL; K entrada 0.50 ESTIMADO
Válvula check (retención) 1/2" | 1 | 1/2" | Evita retorno al tinaco y mantiene cebada la succión | Rosca hembra-hembra 1/2" | Modelo exacto por definir (columpio o resorte) | PROVISIONAL | K = 2.70 ESTIMADO (Crane TP-410 columpio); sensibilidad 1.5-16.2. Si es de resorte verificar presión de apertura
Bomba de diafragma 12 V | 1 | 12 V / 6 A / 72 W; 6 L/min máx.; pressure setting 0.9 MPa | Impulsión | Puertos roscados (estándar pendiente) | GOOD PUMPS (placa) | CONFIRMADO | Equipo disponible. Curva Q-H PROVISIONAL (no publicada). PENDIENTE prueba física: curva Q-H real y posible ciclado del presostato trabajando con solo 4 SD-B (3.3-4.4 L/min de 6 L/min) (ASSUMPTIONS_AND_PENDING P1/P1b)
Caudalímetro YF-S201 | 1 | G1/2; DI 11 mm; 1-30 L/min | Verificación de flujo (450 pulsos/L; F = 7.5·Q) | Rosca macho G1/2 | YF-S201 | CONFIRMADO | A 3.33 L/min da 25 Hz (dentro de rango). Pérdida de carga sin dato: K = 2.0 ESTIMADO (sensibilidad 0-20)
Electroválvula NC 12 V DC | 1 | 1/2" | Abre/cierra la zona de riego | Rosca 1/2" (tipo por confirmar) | Modelo exacto por confirmar | CONFIRMADO | Kv PENDIENTE (Kv = 3 ESTIMADO -> K 7.65; sensibilidad Kv 1-6). Si es de membrana con piloto verificar presión diferencial mínima de apertura
Microaspersor Hunter Solo-Drip SD-B | 4 | 360°; espiga 6 mm; tabla oficial 40/50/60 L/h a 1.0/1.5/2.0 bar, Ø mojado 0.5/0.6/0.8 m; rango 0.5-2.5 bar | Riego (2 por lateral) | Espiga (barb) 6 mm | Hunter SD-B (SKU SDB) | PROVISIONAL | Datos OFICIALES Hunter (la tabla de desempeño llega a 2.0 bar). Con r=0.30 m la cobertura del cajón es 95 % (falta centro, esquinas y puntos medios de borde); r≈0.36 m requiere ≈1.80 bar (interpolado). Aspersor no definitivo: el modelo es paramétrico
Adaptador rosca 1/2" macho -> espiga 6 mm | 4 | 1/2" NPT x espiga 6 mm | Monta el SD-B en la T de rosca central | Rosca + espiga | Por definir (micro-riego) | PENDIENTE | Disponibilidad y paso interior por confirmar; modelado D 4 mm y K 1.0 ESTIMADO
Filtro de malla 1/2" (mínimo Hunter 100 mesh / 150 micras) | 1 | 1/2"; malla ≥ 100 mesh (≤ 150 µm) | Filtración mínima exigida por Hunter para los SD-B; protege también YF-S201 y electroválvula | Rosca 1/2" | Por definir | PENDIENTE | Requisito OFICIAL de Hunter (filtración mínima 100 mesh / 150 µm). Ubicación en el esquema físico: descarga de la bomba, ANTES del YF-S201. NO incluido aún en el modelo EPANET ni en la tabla de cortes: al elegirlo agregar su K y alargar el corte D (pendiente de montaje M1)
Regulador de presión ~1.5 bar | 0-1 | 1/2" | Limitar presión en aspersores si la bomba real entrega > 2 bar | Rosca 1/2" | Por definir | PENDIENTE | Solo si la curva real lo exige; con la curva provisional los SD-B quedarían a 2.41 bar (fuera de la tabla Hunter ≤ 2.0 bar; caudal 65.9 L/h = extrapolación del modelo). También puede mitigar el ciclado del presostato
Soporte / abrazadera para tubo 20 mm | 8 | 20 mm | Sujeción de la línea principal (cada ~0.6 m) y de la subida | Tornillo | Genérico | ESTIMADO | Cantidad aproximada
Cinta de teflón / sellador de roscas | 2 | rollos 1/2" | Sellado de uniones roscadas | — | Genérico | CONFIRMADO | Rotoplas recomienda apriete a mano + 1/4 de vuelta con herramienta (máx. 16 N·m)
Termofusor Tuboplus con dado 20 mm y tijera corta tubo | 1 | 20 mm | Herramienta de instalación | — | Termofusor Tuboplus 120 V 800 W | PENDIENTE | Tiempos 20 mm: calentamiento 5-12 s según ficha; acople 4 s; enfriamiento 2 min
