JSantiagoGR/AquaHuerto-Escolar/epanet/3/BOM_hidraulico.csv

categoria | componente | cantidad | medida | funcion | conexion | modelo | estado | observaciones
YA INSTALADO | Tinaco | 1 | nivel agua +1.19 m; salida +0.265 m | Reserva de agua | Salida 1/2" | Tinaco actual | PROVISIONAL | Se sustituira; todo parametrizado en CONFIG["tinaco"]
YA INSTALADO | Niple / adaptador de salida del tinaco | 1 | 1/2" | Salida del tinaco | Rosca | — | CONFIRMADO | Existente; K entrada 0.5 ESTIMADO
YA INSTALADO | Valvula de bola manual | 1 | 1/2" | Cierre manual (abierta en riego) | Rosca | — | CONFIRMADO | Existente; K 0.08 ESTIMADO (Crane: paso completo)
YA INSTALADO | Valvula check | 1 | 1/2" | Evita retorno al tinaco | Rosca | — | CONFIRMADO | Existente; K 2.7 ESTIMADO; modelada como Pipe CV
YA INSTALADO | Conector + tramo Tuboplus existente | 1 | 20 mm | Une check con la T | Termofusion/rosca | Tuboplus | CONFIRMADO | Existente; NO cuenta en el limite de 4 m
YA INSTALADO | T Tuboplus existente | 1 | 20 mm | Derivacion existente hacia la bajada | Termofusion | Tuboplus | CONFIRMADO | Existente; orientacion/uso del tercer puerto PENDIENTE (K 1.8 PROVISIONAL)
YA INSTALADO | Bajada vertical Tuboplus existente | 1 | 20 mm; 0.185 m aprox. | Baja de +0.265 a +0.08 m | Termofusion | Tuboplus | CONFIRMADO | Existente; NO cuenta en el limite de 4 m
YA DISPONIBLE | Bomba de diafragma autocebante GOOD PUMPS | 1 | 12 V (9-14.4 V); 6 A; 72 W; 6 L/min max.; corte presostato 0.9 MPa (130 psi) | Impulsion | Puertos rosca macho 3/8" con punta espiga 10 mm | GOOD PUMPS (caja: SKU D2-BXSB; codigo PKAV94551) | CONFIRMADO | Curva Q-H NO publicada (PROVISIONAL). Servicio intermitente segun vendedor. Probar curva y ciclado del presostato
YA DISPONIBLE | Caudalimetro YF-S201 | 1 | G1/2; DI 11 mm; 1-30 L/min | Verificacion de flujo | Rosca macho G1/2 | YF-S201 | CONFIRMADO | 4.5 L/min -> 33.8 Hz; K 2.0 ESTIMADO
YA DISPONIBLE | Electrovalvula NC 12 V DC | 1 | 1/2" | Abre/cierra el riego (OPEN en riego) | Rosca 1/2" (macho/hembra por confirmar) | — | CONFIRMADO | Kv PENDIENTE (Kv 3 ESTIMADO -> K 7.65)
YA DISPONIBLE | Manguera negra rigida para laterales | 3 tramos | 3 lineas de ~0.905 m (calculada; + insercion) ; DI 12 mm NO MEDIDO ; DE ~16 mm NO MEDIDO | Laterales de aspersores (solo laterales) | Espiga + abrazadera | — | PENDIENTE DE CONFIRMAR | DI/DE NO MEDIDOS (estimacion visual); medir con vernier y cambiar CONFIG['medidas']['M9_manguera_DI_mm']
YA DISPONIBLE | Aspersores regulables | 9 | ~70 L/h max. (dato verbal) | Riego (3 por lateral) | Por confirmar | Marca/modelo NO identificados (no hubo foto) | PROVISIONAL | Nominal 30 L/h PROVISIONAL; relacion apertura-caudal DESCONOCIDA (no lineal supuesta); presion requerida desconocida
COMPRAR | Tubo Tuboplus PP-R Clase 16 | 1 (4.00 m = LIMITE de compra) | 20 mm x 4.00 m (DI 14.40 mm) | Linea nueva desde el pie de la bajada (escenario A, subida vertical) | Termofusion | Tuboplus 200224 | CONFIRMADO (compra) / longitud PENDIENTE | Diseno A ESTIMADO 5.148 m (> 4.00 m); cumple solo si M1+M5 <= 1.662 m. Decidir tras medir (ver tabla_cortes_tuboplus.csv). Escenario B (45) solo contingencia
COMPRAR | Codo 90 deg Tuboplus | 5 | 20 mm | Escenario A: pie de bajada, base y cima de la subida vertical, 2 brazos exteriores de la cruz | Termofusion | Tuboplus 200014 | CONFIRMADO | K 2.00 OFICIAL
PENDIENTE DE CONFIRMAR | Codo 45 deg Tuboplus | 0 (2 solo si se adopta el escenario B) | 20 mm | Subida a 45 deg - SOLO ALTERNATIVA DE CONTINGENCIA | Termofusion | Tuboplus 200005 | PENDIENTE | No comprar salvo que las mediciones descarten el escenario A
COMPRAR | Cruz Tuboplus | 1 | 20 mm | Distribucion a 3 laterales | Termofusion | Tuboplus 200082 | CONFIRMADO | K de cruz no publicado (PROVISIONAL 1.8 recto / 2.2 lateral)
COMPRAR | Tuerca union mixta Tuboplus | 2 | 20 x 1/2" | Union desmontable en succion y descarga de la bomba | Termofusion + rosca hembra 1/2" | Tuboplus 200235 | CONFIRMADO | Permite retirar la bomba
PENDIENTE DE CONFIRMAR | Adaptacion bomba <-> 1/2" (PENDIENTE DE CONFIRMAR TIPO DE ROSCA 3/8") | 2 | ~3/8" (NPT o BSP sin confirmar) x 1/2" | Adapta puertos de bomba 3/8" a 1/2" | Rosca | Por definir | PENDIENTE | Hipotesis fuerte: puertos ~3/8" compatibles con manguera ~10 mm. NO comprar hasta verificar con galga (NPT 18 h/in vs BSP 19 h/in). Alternativa: manguera corta 10 mm DI + espiga 10 mm x rosca 1/2" (no la manguera negra)
COMPRAR | Conector hembra Tuboplus | 7 | 20 x 1/2" | YF-S201 (2) + electrovalvula (2) + 3 salidas de la cruz | Termofusion + rosca hembra 1/2" | Tuboplus 200039 | CONFIRMADO | K 0.40 OFICIAL; YF-S201 es G1/2 (BSPP) vs NPT de Tuboplus: sellar con PTFE
COMPRAR | Adaptador rosca macho 1/2" x espiga para manguera | 3 | 1/2" x espiga (DI manguera; 12 mm PROVISIONAL) | Transicion cruz -> manguera negra | Rosca + espiga | Por definir | PENDIENTE DE CONFIRMAR | Elegir espiga cuando se mida el DI de la manguera
COMPRAR | Abrazadera sin fin para manguera | 3 | segun DE de la manguera | Fijar manguera en las espigas | — | Generica | CONFIRMADO | Comprar 1-2 de repuesto
COMPRAR | Tapon final para manguera | 3 | segun DI/DE de la manguera | Cierre de cada lateral | Espiga o tapon tipo 8 | Generico | PENDIENTE DE CONFIRMAR | Depende de la medida real de la manguera
COMPRAR | Conexiones de los 9 aspersores a la manguera | 9 | segun aspersor | Toma de cada aspersor sobre el lateral | Inserto/espiga o microtubo | Segun aspersor | PENDIENTE DE CONFIRMAR | Modelado D 4 mm; K 1.0 ESTIMADO
COMPRAR | Soporte para subida vertical y cruz a 1.52 m | 2 | — | Sostener la subida vertical (1.44 m), la cruz y los brazos | — | Generico | PENDIENTE DE CONFIRMAR | Fijar sobre el cajon o al piso; las abrazaderas van sobre el tubo, no sobre accesorios (Manual Tuboplus)
COMPRAR | Abrazadera/soporte para tubo 20 mm | 6 | 20 mm | Sujecion de linea principal y subida | Tornillo | Generica | CONFIRMADO | Cantidad aproximada
COMPRAR | Soporte para laterales elevados | 3 | ~1 m | Mantener los laterales paralelos a 1.52 m | — | Hilo tensor o travesano | PENDIENTE DE CONFIRMAR | Los laterales quedan 1.00 m sobre el cajon
COMPRAR | Cinta PTFE / sellador de roscas | 2 | 1/2" | Sellado de roscas | — | Generica | CONFIRMADO | Apriete a mano + 1/4 de vuelta (max. 16 N·m en roscas Tuboplus)
