JSantiagoGR/AquaHuerto-Escolar/epanet/2/resultados_epanet.csv

tipo | id | descripcion | elev_m | head_m | presion_m | presion_bar | demanda_o_emisor_Ls | caudal_Ls | caudal_Lh | velocidad_ms | headloss_m | estado | nota
nodo | J-TK | Salida del tinaco (rosca 1/2") | 0.265 | 1.1838 | 0.9188 | 0.0900 | 0.000000
nodo | J-CHK | Salida de la valvula check | 0.265 | 1.1546 | 0.8896 | 0.0871 | 0.000000
nodo | J-C1 | Codo 90 superior (baja) | 0.265 | 1.1263 | 0.8613 | 0.0843 | 0.000000
nodo | J-C2 | Codo 90 inferior (a bomba) | 0.080 | 1.1009 | 1.0209 | 0.1000 | 0.000000
nodo | J-PIN | Succion de la bomba | 0.080 | 1.0829 | 1.0029 | 0.0982 | 0.000000
nodo | J-POUT | Descarga de la bomba | 0.080 | 25.6663 | 25.5863 | 2.5055 | 0.000000
nodo | J-FLOW | Entrada YF-S201 | 0.080 | 25.6451 | 25.5651 | 2.5034 | 0.000000
nodo | J-FLOW2 | Salida YF-S201 | 0.080 | 25.5789 | 25.4989 | 2.4969 | 0.000000
nodo | J-EV1 | Entrada electrovalvula | 0.080 | 25.5672 | 25.4872 | 2.4958 | 0.000000
nodo | J-EV2 | Salida electrovalvula | 0.080 | 25.4861 | 25.4061 | 2.4879 | 0.000000
nodo | J-R1 | Codo inferior de la subida | 0.080 | 25.3895 | 25.3095 | 2.4784 | 0.000000
nodo | J-R2 | Codo superior de la subida | 0.530 | 25.3573 | 24.8273 | 2.4312 | 0.000000
nodo | J-T | T centrada de distribucion | 0.530 | 25.3325 | 24.8025 | 2.4287 | 0.000000
nodo | J-CL | Codo lateral 1 | 0.530 | 25.3257 | 24.7957 | 2.4281 | 0.000000
nodo | J-CR | Codo lateral 2 | 0.530 | 25.3257 | 24.7957 | 2.4281 | 0.000000
nodo | T-E1 | Tee aspersor 1 (L1, A) | 0.530 | 25.3223 | 24.7923 | 2.4277 | 0.000000
nodo | T-E2 | Tee aspersor 2 (L1, B) | 0.530 | 25.3209 | 24.7909 | 2.4276 | 0.000000
nodo | T-E3 | Tee aspersor 3 (L2, A) | 0.530 | 25.3223 | 24.7923 | 2.4277 | 0.000000
nodo | T-E4 | Tee aspersor 4 (L2, B) | 0.530 | 25.3209 | 24.7909 | 2.4276 | 0.000000
nodo | E1 | Microaspersor 1 SD-B (L1, A) | 0.560 | 25.1827 | 24.6227 | 2.4111 | 0.018314 |  | 65.93 |  |  |  | EXTRAPOLACION DEL MODELO (P > 2.0 bar: fuera de la tabla oficial Hunter; NO es dato Hunter)
nodo | E2 | Microaspersor 2 SD-B (L1, B) | 0.560 | 25.1813 | 24.6213 | 2.4110 | 0.018314 |  | 65.93 |  |  |  | EXTRAPOLACION DEL MODELO (P > 2.0 bar: fuera de la tabla oficial Hunter; NO es dato Hunter)
nodo | E3 | Microaspersor 3 SD-B (L2, A) | 0.560 | 25.1827 | 24.6227 | 2.4111 | 0.018314 |  | 65.93 |  |  |  | EXTRAPOLACION DEL MODELO (P > 2.0 bar: fuera de la tabla oficial Hunter; NO es dato Hunter)
nodo | E4 | Microaspersor 4 SD-B (L2, B) | 0.560 | 25.1813 | 24.6213 | 2.4110 | 0.018314 |  | 65.93 |  |  |  | EXTRAPOLACION DEL MODELO (P > 2.0 bar: fuera de la tabla oficial Hunter; NO es dato Hunter)
nodo | TAP1 | Tapon final lateral 1 | 0.530 | 25.3209 | 24.7909 | 2.4276 | 0.000000
nodo | TAP2 | Tapon final lateral 2 | 0.530 | 25.3209 | 24.7909 | 2.4276 | 0.000000
nodo | R1 | TINACO R1 | 1.190 | 1.1900 | 0.0000 | 0.0000 | -0.073256
enlace | P-TK | Salida/niple del tinaco |  |  |  |  |  | 0.073256 | 263.72 | 0.4498 | 0.00618 | ABIERTO
enlace | CHK | VALVULA CHECK 1/2" (solo tinaco->bomba) |  |  |  |  |  | 0.073256 | 263.72 | 0.4498 | 0.02924 | ABIERTO
enlace | T-A | Tubo corto + codo 90 |  |  |  |  |  | 0.073256 | 263.72 | 0.4498 | 0.02831 | ABIERTO
enlace | T-B | Bajada vertical + codo 90 |  |  |  |  |  | 0.073256 | 263.72 | 0.4498 | 0.02537 | ABIERTO
enlace | T-C | Tubo a bomba + union mixta + adaptador |  |  |  |  |  | 0.073256 | 263.72 | 0.4498 | 0.01795 | ABIERTO
enlace | T-D | Adaptador + union mixta + tubo + conector |  |  |  |  |  | 0.073256 | 263.72 | 0.4498 | 0.02117 | ABIERTO
enlace | YF | CAUDALIMETRO YF-S201 (D int 11 mm) |  |  |  |  |  | 0.073256 | 263.72 | 0.7708 | 0.06627 | ABIERTO
enlace | T-E | Conectores + tubo |  |  |  |  |  | 0.073256 | 263.72 | 0.4498 | 0.01169 | ABIERTO
enlace | EV | ELECTROVALVULA NC 12 V (OPEN en riego) |  |  |  |  |  | 0.073256 | 263.72 | 0.4498 | 0.08106 | ABIERTO
enlace | T-F | LINEA PRINCIPAL + codo 90 |  |  |  |  |  | 0.073256 | 263.72 | 0.4498 | 0.09667 | ABIERTO
enlace | T-G | SUBIDA al cajon + codo 90 |  |  |  |  |  | 0.073256 | 263.72 | 0.4498 | 0.03219 | ABIERTO
enlace | T-H | Tramo a T + T division |  |  |  |  |  | 0.073256 | 263.72 | 0.4498 | 0.02481 | ABIERTO
enlace | BR-L | Brazo izquierdo + codo |  |  |  |  |  | 0.036628 | 131.86 | 0.2249 | 0.00674 | ABIERTO
enlace | BR-R | Brazo derecho + codo |  |  |  |  |  | 0.036628 | 131.86 | 0.2249 | 0.00674 | ABIERTO
enlace | L1-A | LATERAL 1 tramo a aspersor 1 |  |  |  |  |  | 0.036628 | 131.86 | 0.2249 | 0.00343 | ABIERTO
enlace | L1-B | LATERAL 1 tramo a aspersor 2 |  |  |  |  |  | 0.018314 | 65.93 | 0.1125 | 0.00142 | ABIERTO
enlace | L1-T | Niple + tapon L1 (sin flujo) |  |  |  |  |  | 0.000000 | 0.00 | 0.0000 | 0.00000 | ABIERTO
enlace | L2-A | LATERAL 2 tramo a aspersor 3 |  |  |  |  |  | 0.036628 | 131.86 | 0.2249 | 0.00343 | ABIERTO
enlace | L2-B | LATERAL 2 tramo a aspersor 4 |  |  |  |  |  | 0.018314 | 65.93 | 0.1125 | 0.00142 | ABIERTO
enlace | L2-T | Niple + tapon L2 (sin flujo) |  |  |  |  |  | 0.000000 | 0.00 | 0.0000 | 0.00000 | ABIERTO
enlace | RE1 | Adaptador 1/2"->espiga 6 mm |  |  |  |  |  | 0.018314 | 65.93 | 1.4574 | 0.13956 | ABIERTO
enlace | RE2 | Adaptador 1/2"->espiga 6 mm |  |  |  |  |  | 0.018314 | 65.93 | 1.4574 | 0.13955 | ABIERTO
enlace | RE3 | Adaptador 1/2"->espiga 6 mm |  |  |  |  |  | 0.018314 | 65.93 | 1.4574 | 0.13956 | ABIERTO
enlace | RE4 | Adaptador 1/2"->espiga 6 mm |  |  |  |  |  | 0.018314 | 65.93 | 1.4574 | 0.13955 | ABIERTO
enlace | PU1 | BOMBA PU1 (curva provisional) |  |  |  |  |  | 0.073256 | 263.72 | 0.0000 | -24.58337 | ABIERTO
