JSantiagoGR/AquaHuerto-Escolar/documentacion/EXPOSICION_AquaHuerto/2_Documentacion_tecnica/19_Fotografias/2_Componentes/01_bateria_etiqueta.jpg

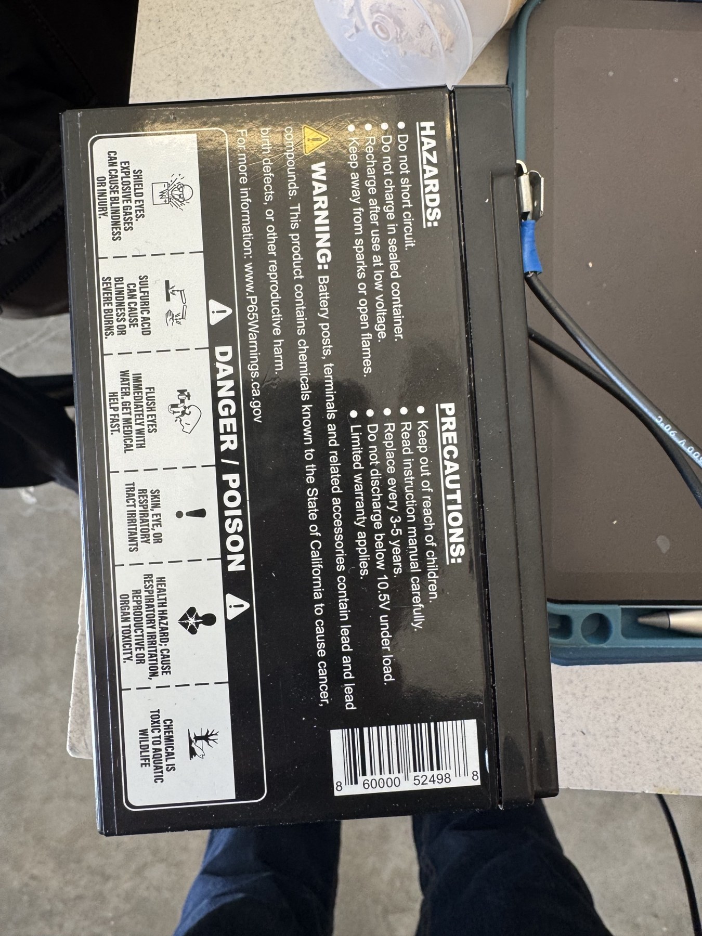
documentacion/EXPOSICION_AquaHuerto/2_Documentacion_tecnica/19_Fotografias/2_Componentes/01_bateria_etiqueta.jpg
