JSantiagoGR/AquaHuerto-Escolar/documentacion/EXPOSICION_AquaHuerto/2_Documentacion_tecnica/19_Fotografias/2_Componentes/02_reles_y_ultrasonico.jpg

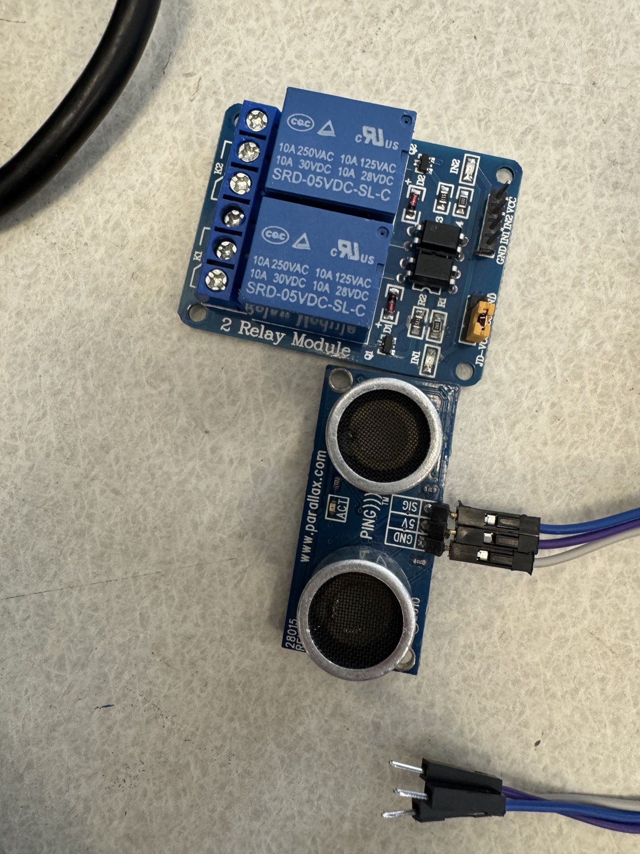
documentacion/EXPOSICION_AquaHuerto/2_Documentacion_tecnica/19_Fotografias/2_Componentes/02_reles_y_ultrasonico.jpg
