JSantiagoGR/AquaHuerto-Escolar/documentacion/EXPOSICION_AquaHuerto/2_Documentacion_tecnica/19_Fotografias/2_Componentes/03_electrovalvula.jpg

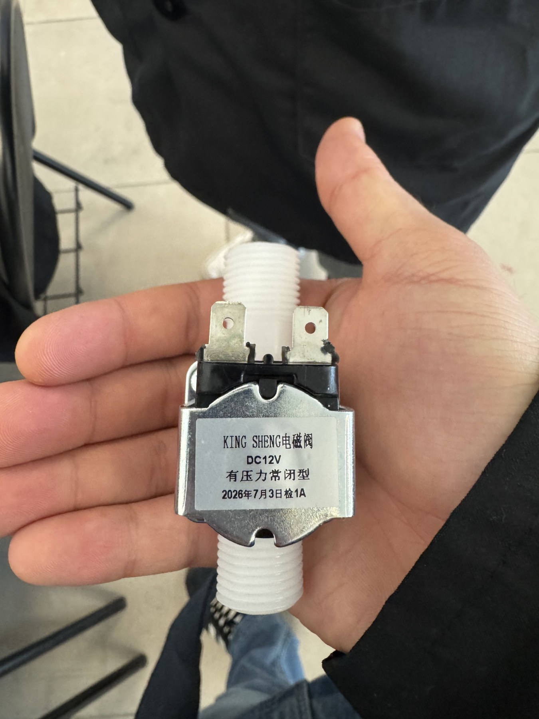
documentacion/EXPOSICION_AquaHuerto/2_Documentacion_tecnica/19_Fotografias/2_Componentes/03_electrovalvula.jpg
