JSantiagoGR/AquaHuerto-Escolar/documentacion/EXPOSICION_AquaHuerto/2_Documentacion_tecnica/06_Planos_CAD/modelos_3D/STEP/Ensamble_AquaHuerto.step

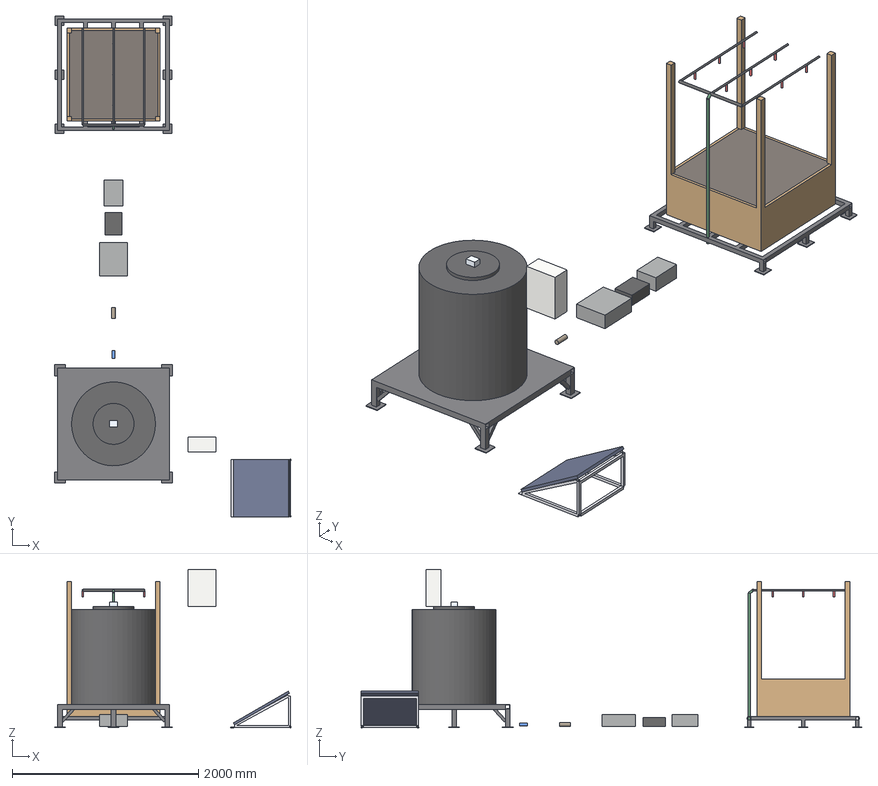
[picture p183: CAD file, 2026-11-08]
documentacion/EXPOSICION_AquaHuerto/2_Documentacion_tecnica/06_Planos_CAD/modelos_3D/STEP/Ensamble_AquaHuerto.step
2536.4 x 5380.0 x 1700.0 mm
base_huerto
cajon
sustrato
base_tinaco
tinaco
sensor_nivel
gabinete
soporte_panel
panel_solar
tuberia
mangueras
microaspersores
caja_valvula
caja_caudalimetro
caja_bomba
valvula_esfera
filtro_y
