JSantiagoGR/AquaHuerto-Escolar/documentacion/EXPOSICION_AquaHuerto/2_Documentacion_tecnica/06_Planos_CAD/modelos_3D/descargas/kicad_oficial/SOT-223.step

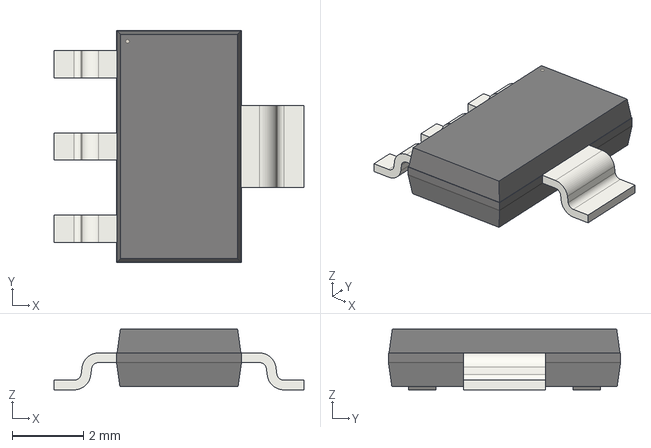
[picture p184: CAD file, 2026-11-08]
documentacion/EXPOSICION_AquaHuerto/2_Documentacion_tecnica/06_Planos_CAD/modelos_3D/descargas/kicad_oficial/SOT-223.step
7.00 x 6.50 x 1.70 mm
