JSantiagoGR/AquaHuerto-Escolar/documentacion/EXPOSICION_AquaHuerto/2_Documentacion_tecnica/06_Planos_CAD/modelos_3D/descargas/rele_soldered/2-channel relay board 3D.step

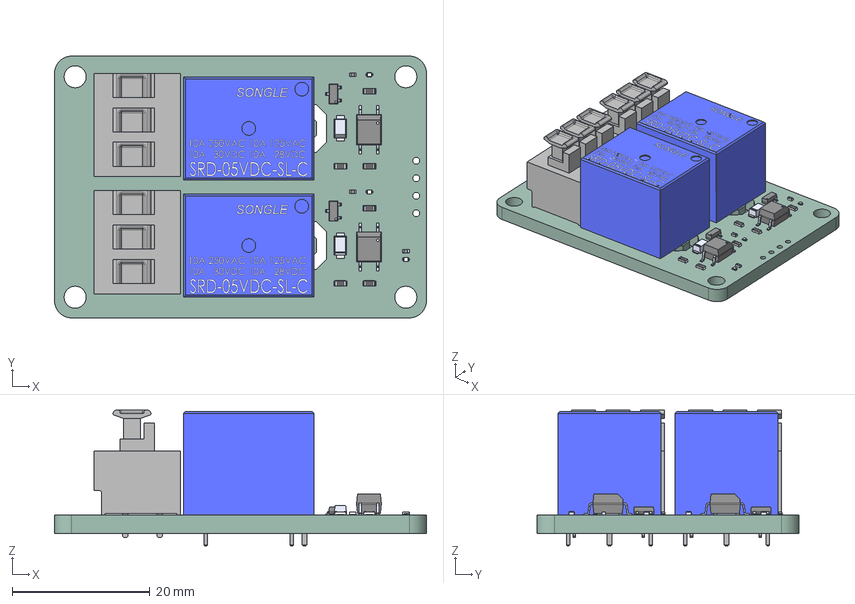
[picture p185: CAD file, 2026-11-08]
documentacion/EXPOSICION_AquaHuerto/2_Documentacion_tecnica/06_Planos_CAD/modelos_3D/descargas/rele_soldered/2-channel relay board 3D.step
54.0 x 38.0 x 19.7 mm
DBZ3 x 2
RL0402JR-070R51L x 3
PC365NJ0000F x 2
User Library-R0603-1 x 6
SML-P11MTT86 x 3
relay srd05vdc-sl-c x 2
User Library-sub-sma x 2
KF232 3P x 2
2-channel relay board_PCB
