JSantiagoGR/AquaHuerto-Escolar/documentacion/EXPOSICION_AquaHuerto/2_Documentacion_tecnica/06_Planos_CAD/modelos_3D/STEP/Tinaco.step

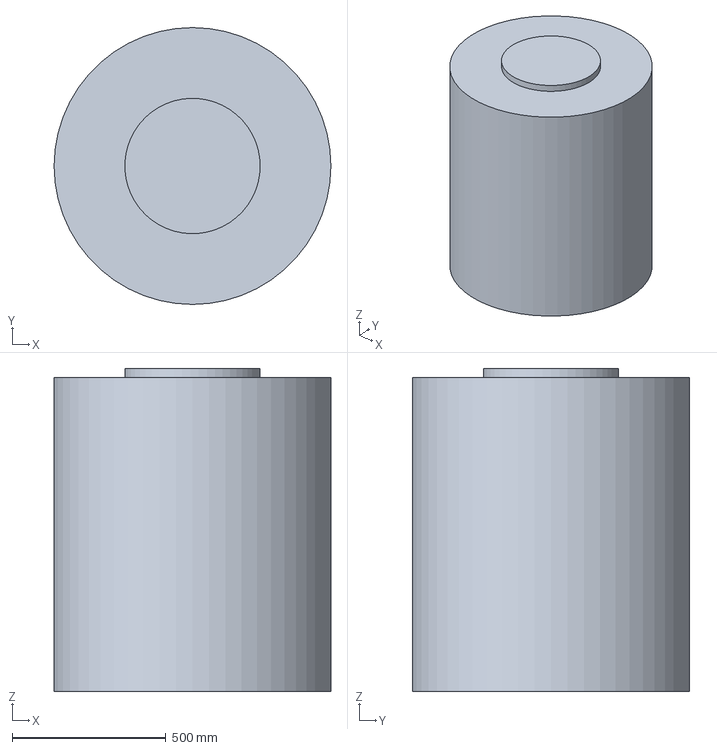
[picture p186: CAD file, 2026-11-08]
documentacion/EXPOSICION_AquaHuerto/2_Documentacion_tecnica/06_Planos_CAD/modelos_3D/STEP/Tinaco.step
900.0 x 900.0 x 1050.0 mm
