JSantiagoGR/AquaHuerto-Escolar/documentacion/EXPOSICION_AquaHuerto/2_Documentacion_tecnica/06_Planos_CAD/modelos_3D/STL/ensamble/caja_caudalimetro.stl

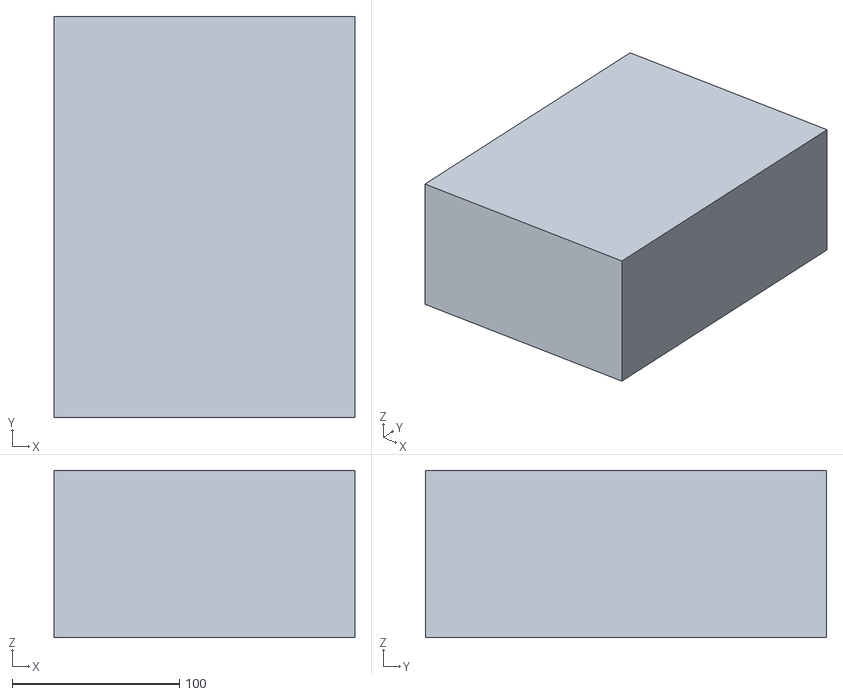
[picture p187: CAD file, 2026-11-08]
documentacion/EXPOSICION_AquaHuerto/2_Documentacion_tecnica/06_Planos_CAD/modelos_3D/STL/ensamble/caja_caudalimetro.stl
180.0 x 240.0 x 100.0
