JSantiagoGR/AquaHuerto-Escolar/documentacion/EXPOSICION_AquaHuerto/2_Documentacion_tecnica/06_Planos_CAD/modelos_3D/descargas/kicad_oficial/USB_Micro-B_Molex_47346-0001.step

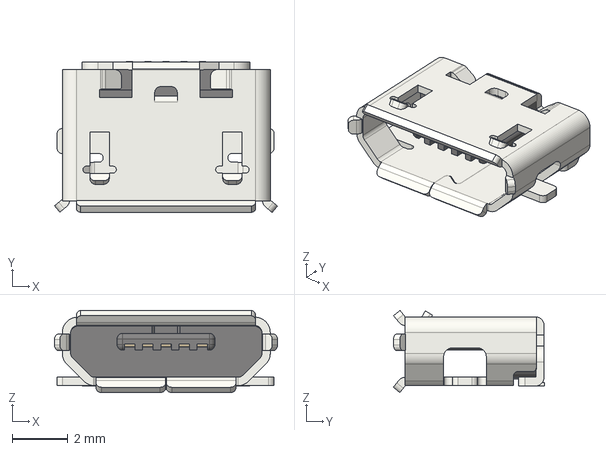
[picture p188: CAD file, 2026-11-08]
documentacion/EXPOSICION_AquaHuerto/2_Documentacion_tecnica/06_Planos_CAD/modelos_3D/descargas/kicad_oficial/USB_Micro-B_Molex_47346-0001.step
7.98 x 5.42 x 2.94 mm
