JSantiagoGR/AquaHuerto-Escolar/documentacion/EXPOSICION_AquaHuerto/2_Documentacion_tecnica/06_Planos_CAD/modelos_3D/descargas/kicad_oficial/ESP32-WROOM-32.step

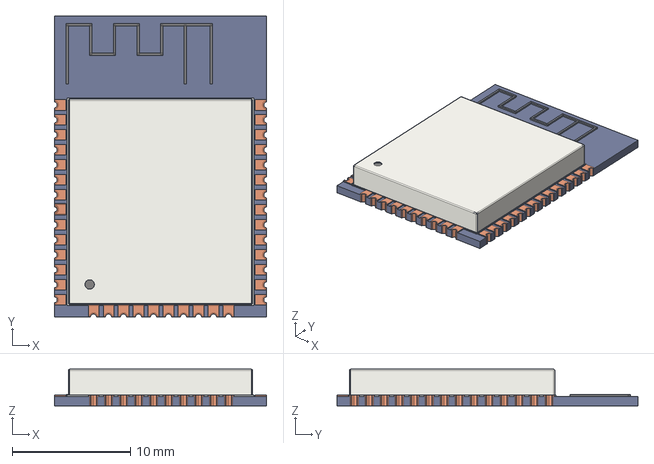
[picture p191: CAD file, 2026-11-08]
documentacion/EXPOSICION_AquaHuerto/2_Documentacion_tecnica/06_Planos_CAD/modelos_3D/descargas/kicad_oficial/ESP32-WROOM-32.step
18.0 x 25.5 x 3.10 mm
