JSantiagoGR/AquaHuerto-Escolar/documentacion/EXPOSICION_AquaHuerto/2_Documentacion_tecnica/06_Planos_CAD/modelos_3D/STEP/Soporte_del_panel_solar.step

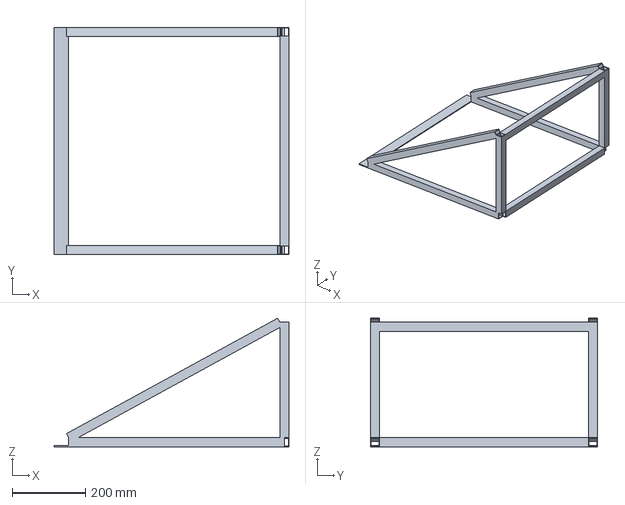
[picture p192: CAD file, 2026-11-08]
documentacion/EXPOSICION_AquaHuerto/2_Documentacion_tecnica/06_Planos_CAD/modelos_3D/STEP/Soporte_del_panel_solar.step
641.4 x 620.0 x 351.0 mm
