JSantiagoGR/AquaHuerto-Escolar/documentacion/EXPOSICION_AquaHuerto/2_Documentacion_tecnica/06_Planos_CAD/modelos_3D/descargas/kicad_oficial/PinHeader_1x03_P2.54mm_Vertical.step

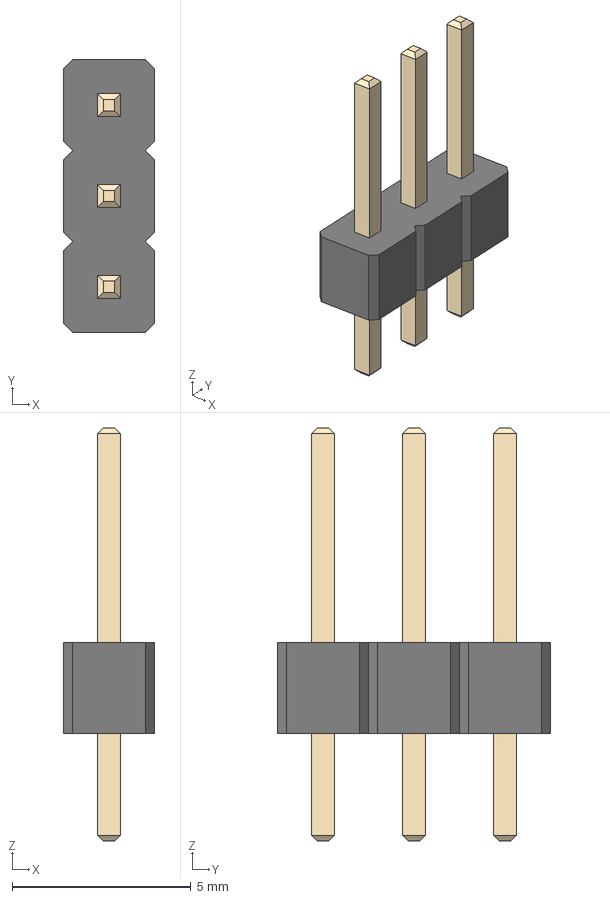
[picture p194: CAD file, 2026-11-08]
documentacion/EXPOSICION_AquaHuerto/2_Documentacion_tecnica/06_Planos_CAD/modelos_3D/descargas/kicad_oficial/PinHeader_1x03_P2.54mm_Vertical.step
2.54 x 7.62 x 11.5 mm
