JSantiagoGR/AquaHuerto-Escolar/documentacion/EXPOSICION_AquaHuerto/2_Documentacion_tecnica/06_Planos_CAD/modelos_3D/descargas/kicad_oficial/PinHeader_1x15_P2.54mm_Vertical.step

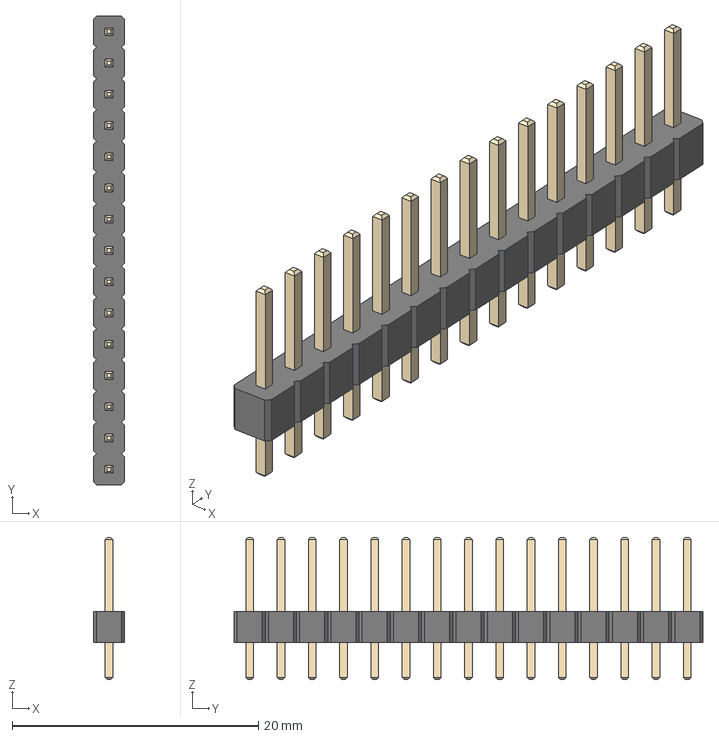
[picture p196: CAD file, 2026-11-08]
documentacion/EXPOSICION_AquaHuerto/2_Documentacion_tecnica/06_Planos_CAD/modelos_3D/descargas/kicad_oficial/PinHeader_1x15_P2.54mm_Vertical.step
2.54 x 38.1 x 11.5 mm
