JSantiagoGR/AquaHuerto-Escolar/documentacion/EXPOSICION_AquaHuerto/2_Documentacion_tecnica/06_Planos_CAD/modelos_3D/descargas/kicad_oficial/QFN-28-1EP_5x5mm_P0.5mm_EP3.35x3.35mm.step

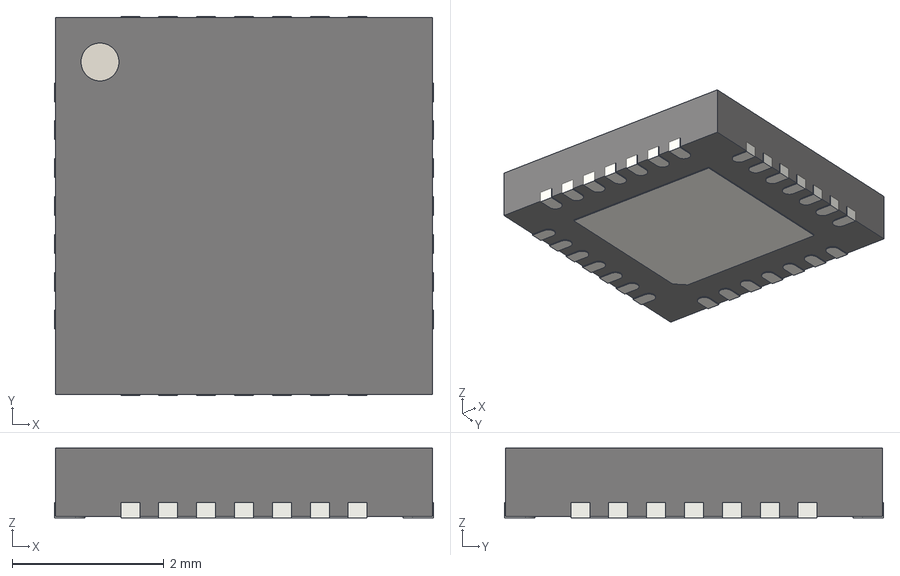
[picture p202: CAD file, 2026-11-08]
documentacion/EXPOSICION_AquaHuerto/2_Documentacion_tecnica/06_Planos_CAD/modelos_3D/descargas/kicad_oficial/QFN-28-1EP_5x5mm_P0.5mm_EP3.35x3.35mm.step
5.00 x 5.00 x 0.92 mm
