JSantiagoGR/AquaHuerto-Escolar/documentacion/EXPOSICION_AquaHuerto/2_Documentacion_tecnica/06_Planos_CAD/modelos_3D/descargas/kicad_oficial/PinSocket_1x15_P2.54mm_Vertical.step

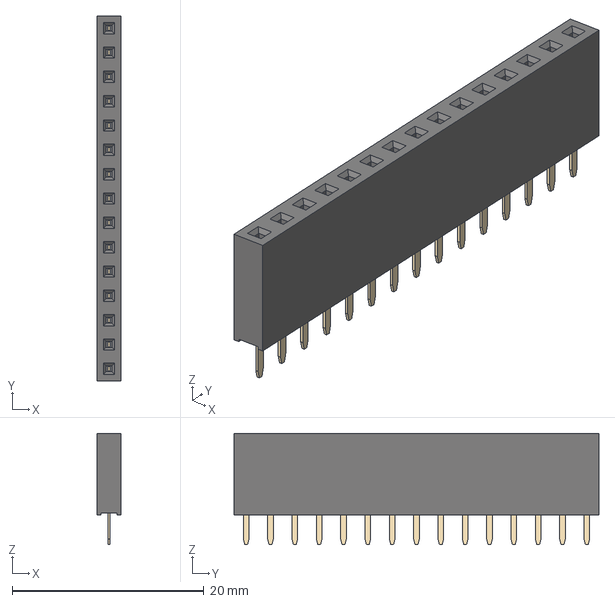
[picture p208: CAD file, 2026-11-08]
documentacion/EXPOSICION_AquaHuerto/2_Documentacion_tecnica/06_Planos_CAD/modelos_3D/descargas/kicad_oficial/PinSocket_1x15_P2.54mm_Vertical.step
2.54 x 38.1 x 11.6 mm
