JSantiagoGR/AquaHuerto-Escolar/documentacion/EXPOSICION_AquaHuerto/2_Documentacion_tecnica/19_Fotografias/1_Construccion_e_instalacion/06_letrero_escuela.jpg

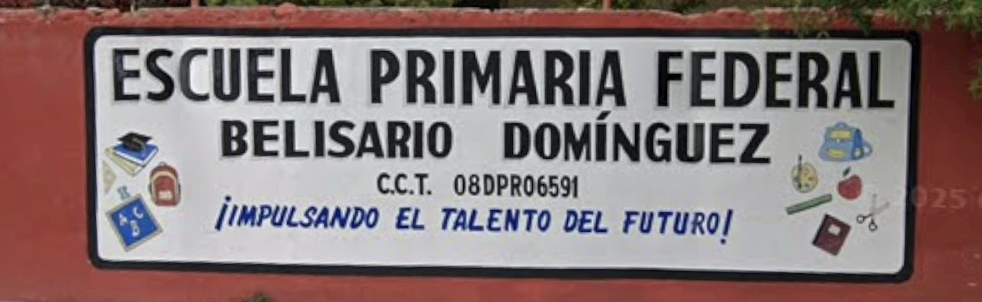
documentacion/EXPOSICION_AquaHuerto/2_Documentacion_tecnica/19_Fotografias/1_Construccion_e_instalacion/06_letrero_escuela.jpg
