JSantiagoGR/AquaHuerto-Escolar/documentacion/manuales/v2/img/p_linea.jpg

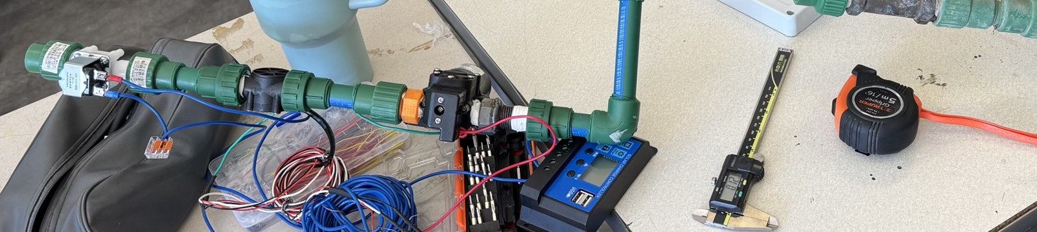
documentacion/manuales/v2/img/p_linea.jpg
