JSantiagoGR/AquaHuerto-Escolar/proyecto_final_v1/resultado_qemu.txt

QEMU: qemu-system-xtensa.exe -machine esp32 -display none -drive file=C:\ESP32_Riego_Automatico\Proyecto_Final_v1\build_qemu\qemu_flash.bin,if=mtd,format=raw -global driver=timer.esp32.timg,property=wdt_disable,value=true -serial tcp:127.0.0.1:5555,server,nowait -monitor none
   | I
   | (
   | 1
   | 3
   | 7
   | 9
   | )
   | c
   | p
   | u
   | _
   | s
   | t
   | a
   | r
   | t
   | :
   | M
   | u
   | l
   | t
   | i
   | c
   | o
   | r
   | e
   | a
   | p
   | p
   | I
   | (
   | 2
   | 4
   | 3
   | 4
   | )
   | c
   | p
   | u
   | _
   | s
   | t
   | a
   | r
   | t
   | :
   | G
   | P
   | I
   | O
   | 3
   | a
   | n
   | d
   | 1
   | a
   | r
   | e
   | u
   | s
   | e
   | d
   | a
   | s
   | c
   | o
   | n
   | s
   | o
   | l
   | e
   | U
   | A
   | R
   | T
   | I
   | /
   | O
   | p
   | i
   | n
   | s
   | I
   |  (
   | 2
   | 4
   | 4
   | 4)
   | c
   | p
   | u
   | _
   | s
   | t
   | a
   | r
   | t
   | :
   | P
   | r
   | o
   | c
   | p
   | u
   | s
   | t
   | a
   | r
   | t
   | us
   | e
   | r
   | c
   | o
   | d
   | e
   | I
   | (
   | 2
   | 4
   | 4
   | 6
   | )
   | c
   | p
   | u
   | _
   | s
   | t
   | art
   | :
   | c
   | pu
   | f
   | r
   | e
   | q
   | :
   | 1
   | 6
   | 0
   | 0
   | 0
   | 0
   | 0
   | 0
   | 0
   | H
   | z
   | I
   | (
   | 2
   | 4
   | 4
   | 7
   | )
   |  a
   | p
   | p
   | _
   | i
   | ni
   | t:
   | A
   | p
   | p
   | l
   | i
   | c
   | a
   | t
   | i
   | o
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
   | s
   | =
   | 3
   | 0
   | .
   | 0
   | 6
   | )
   | t
   | s
   | =
   | 0
   | M
   | A
   | N
   | U
   | A
   | L
   | T
   | A
   | R
   | G
   | E
   | T
   | 1
   | .
   | 0
   | 0
   | 0
   | L
   | 1
   | 5
   | s
   | a
   | n
   | t
   | e
   | s
   | =
   | 3
   | 0
   | .
   | 0
   | d
   | e
   | s
   | p
   | u
   | e
   | s
   | =
   | 3
   | 0
   | .
   | 0
   | O
   | K
   | :
   | H
   | i
   | s
   | t
   | o
   | r
   | i
   | a
   | l
   | p
   | u
   | b
   | l
   | i
   | c
   | a
   | d
   | o
[PASS] Historial guardado en NVS (incluye REBOOT)

QEMU RESULTADO: 32 PASS, 0 FAIL
