JSantiagoGR/AquaHuerto-Escolar/sistema/tests/resultados/riego_1L_red_20261014_1030.csv

t | estado | bomba | valvula | litros | caudal | suelo_mV | suelo_vwc | tinaco_cm | tinaco_pct | temp | hr
2.7 | MANUAL_WATERING | False | True | 0 | 0
2.9 | MANUAL_WATERING | True | True | 0 | 0
5.4 | MANUAL_WATERING | True | True | 0 | 0 | 597 | 32.8 | 110.7 | 6 | 21.6 | 49.2
7.2 | MANUAL_WATERING | True | True | 0 | 0 | 597 | 32.8 | 110.7 | 6 | 21.6 | 49.2
7.3 | MANUAL_WATERING | True | True | 0 | 0 | 597 | 32.8 | 110.7 | 6 | 21.6 | 49.2
7.4 | MANUAL_WATERING | True | True | 0 | 0 | 597 | 32.8 | 110.7 | 6 | 21.6 | 49.2
8.5 | MANUAL_WATERING | True | True | 0 | 0 | 597 | 32.8 | 110.7 | 6 | 21.6 | 49.2
8.8 | MANUAL_WATERING | True | True | 0 | 0 | 597 | 32.8 | 110.7 | 6 | 21.6 | 49.2
10.5 | MANUAL_WATERING | True | True | 0 | 0 | 597 | 32.8 | 110.7 | 6 | 21.6 | 49.2
10.5 | MANUAL_WATERING | True | True | 0 | 0 | 597 | 32.8 | 110.7 | 6 | 21.6 | 49.2
10.6 | MANUAL_WATERING | True | True | 0 | 0 | 597 | 32.8 | 110.7 | 6 | 21.6 | 49.2
11.2 | MANUAL_WATERING | True | True | 0 | 0 | 597 | 32.8 | 110.7 | 6 | 21.6 | 49.2
11.5 | MANUAL_WATERING | True | True | 0 | 0 | 597 | 32.8 | 110.7 | 6 | 21.6 | 49.2
14.2 | MANUAL_WATERING | True | True | 0 | 0 | 597 | 32.8 | 110.7 | 6 | 21.6 | 49.3
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
