JSantiagoGR/AquaHuerto-Escolar/sistema/tests/resultados/riego_2L_20261013_1613.csv

t_s | fase | estado | bomba | valvula | flujo_lpm | pulsos | suelo_mV | suelo_vwc | suelo_estado | tinaco_cm | tinaco_estado | temp_c | hr_pct
3.0 | antes | IDLE | OFF | OFF | 0.0 | 0 | 142 | -12.4 | SIN_SENAL | 0.0 | SIN_ECO | 25.0 | 49.4
5.0 | antes | IDLE | OFF | OFF | 0.0 | 0 | 142 | -12.4 | SIN_SENAL | 0.0 | SIN_ECO | 25.0 | 49.4
7.1 | antes | IDLE | OFF | OFF | 0.0 | 0 | 142 | -12.4 | SIN_SENAL | 0.0 | SIN_ECO | 25.0 | 49.4
9.2 | antes | IDLE | OFF | OFF | 0.0 | 0 | 142 | -12.4 | SIN_SENAL | 0.0 | SIN_ECO | 25.0 | 49.4
14.2 | riego | MANUAL_WATERING | ON | ON | 1.97 | 38 | 142 | -12.4 | SIN_SENAL | 0.0 | SIN_ECO | 25.0 | 49.6
16.3 | riego | MANUAL_WATERING | ON | ON | 1.85 | 68 | 142 | -12.4 | SIN_SENAL | 0.0 | SIN_ECO | 25.0 | 49.6
18.4 | riego | MANUAL_WATERING | ON | ON | 1.86 | 95 | 142 | -12.4 | SIN_SENAL | 0.0 | SIN_ECO | 25.0 | 49.6
20.4 | riego | MANUAL_WATERING | ON | ON | 1.85 | 125 | 142 | -12.4 | SIN_SENAL | 0.0 | SIN_ECO | 25.0 | 49.6
22.5 | riego | MANUAL_WATERING | ON | ON | 1.84 | 153 | 142 | -12.4 | SIN_SENAL | 0.0 | SIN_ECO | 25.1 | 49.6
24.6 | riego | MANUAL_WATERING | ON | ON | 1.72 | 179 | 142 | -12.4 | SIN_SENAL | 0.0 | SIN_ECO | 25.1 | 49.6
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
