JSantiagoGR/AquaHuerto-Escolar/documentacion/EXPOSICION_AquaHuerto/2_Documentacion_tecnica/19_Fotografias/3_Mediciones_y_pruebas/05_tinaco_medicion_borde.jpg

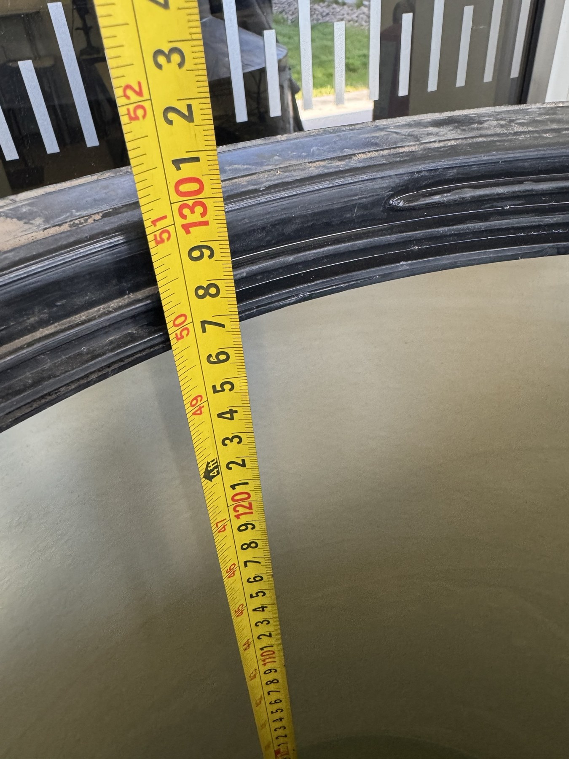
documentacion/EXPOSICION_AquaHuerto/2_Documentacion_tecnica/19_Fotografias/3_Mediciones_y_pruebas/05_tinaco_medicion_borde.jpg
