JSantiagoGR/AquaHuerto-Escolar/documentacion/EXPOSICION_AquaHuerto/2_Documentacion_tecnica/19_Fotografias/3_Mediciones_y_pruebas/08_salida_tinaco_cinta.jpg

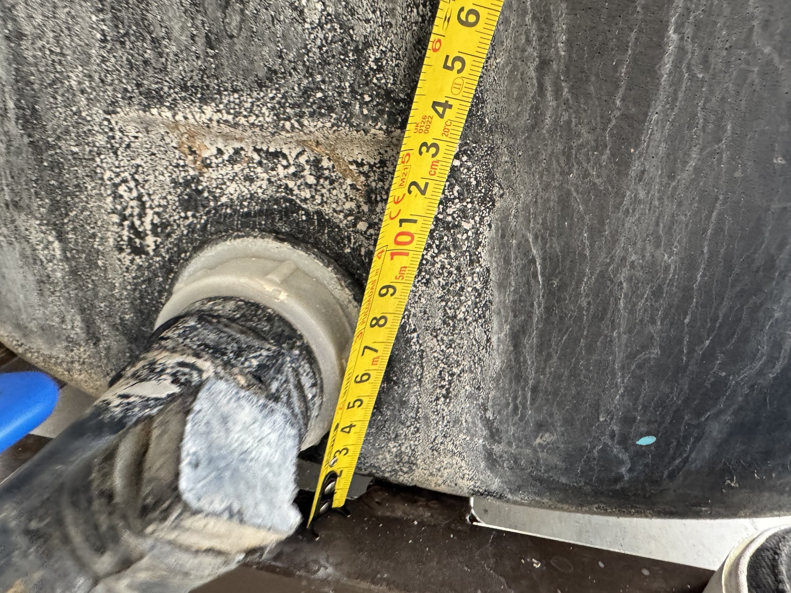
documentacion/EXPOSICION_AquaHuerto/2_Documentacion_tecnica/19_Fotografias/3_Mediciones_y_pruebas/08_salida_tinaco_cinta.jpg
