JSantiagoGR/AquaHuerto-Escolar/epanet/3/reporte/generar_reporte.py

"""Genera el reporte Word del sistema de riego v3 (escenario A, construido).
Uso (desde la carpeta 3):
    python reporte/generar_figuras.py      # figuras + datos_reporte.json
    python reporte/generar_reporte.py      # Reporte_Riego_Automatizado_v3.docx
Los datos de portada se editan en PORTADA. Los números salen de resultados_calculo.json (generar_modelo.py)."""
import csv, json, os, re
from docx import Document
from docx.enum.section import WD_SECTION
from docx.enum.table import WD_TABLE_ALIGNMENT, WD_CELL_VERTICAL_ALIGNMENT
from docx.enum.text import WD_ALIGN_PARAGRAPH, WD_BREAK, WD_TAB_ALIGNMENT
from docx.oxml import OxmlElement
from docx.oxml.ns import qn
from docx.shared import Pt, Cm, Inches, RGBColor

AQUI = os.path.dirname(os.path.abspath(__file__))
RAIZ = os.path.dirname(AQUI)
SALIDA = os.path.join(AQUI, "Reporte_Riego_Automatizado_v3.docx")
D = json.load(open(os.path.join(AQUI, "datos_reporte.json"), encoding="utf8"))
DIMS = json.load(open(os.path.join(AQUI, "dims.json"), encoding="utf8"))

# ---------------------------------------------------------------- PORTADA (editar aquí) -----
PORTADA = {
    "institucion": "Instituto Tecnológico y de Estudios Superiores de Monterrey",
    "escuela": "Escuela de Ingeniería y Ciencias",
    "campus": "Campus [CAMPUS]",
    "materia": "[CLAVE] Automatización industrial — Grupo [GRUPO]",
    "titulo": "Diseño, modelado hidráulico en EPANET e implementación de un sistema de riego automatizado por aspersión para un huerto elevado",
    "subtitulo": "Reporte técnico del reto",
    "integrantes": [("[NOMBRE COMPLETO 1]", "[MATRÍCULA]"), ("[NOMBRE COMPLETO 2]", "[MATRÍCULA]"),
                    ("[NOMBRE COMPLETO 3]", "[MATRÍCULA]"), ("[NOMBRE COMPLETO 4]", "[MATRÍCULA]"),
                    ("[NOMBRE COMPLETO 5]", "[MATRÍCULA]")],
    "profesor": "[NOMBRE DEL PROFESOR(A)]",
    "lugar_fecha": "[Ciudad], [día] de [mes] de 2026",
}

FUENTE = "Arial"
AZUL = RGBColor(0x1F, 0x3A, 0x5F)
rows = {r["id"]: r for r in D["rows"]}
res, esc, geo, nodes, links = D["res"], D["esc"], D["geo"], D["nodes"], D["links"]


def f(x, n=3):
    return f"{x:,.{n}f}".replace(",", " ")


# ---------------------------------------------------------------- utilidades XML ------------
def campo(par, instr, texto="Actualice los campos (F9)"):
    r = par.add_run(); e = OxmlElement("w:fldChar"); e.set(qn("w:fldCharType"), "begin"); r._r.append(e)
    r = par.add_run(); t = OxmlElement("w:instrText"); t.set(qn("xml:space"), "preserve"); t.text = instr; r._r.append(t)
    r = par.add_run(); e = OxmlElement("w:fldChar"); e.set(qn("w:fldCharType"), "separate"); r._r.append(e)
    par.add_run(texto)
    r = par.add_run(); e = OxmlElement("w:fldChar"); e.set(qn("w:fldCharType"), "end"); r._r.append(e)


def sombrear(celda, color):
    tcPr = celda._tc.get_or_add_tcPr(); s = OxmlElement("w:shd")
    s.set(qn("w:val"), "clear"); s.set(qn("w:color"), "auto"); s.set(qn("w:fill"), color); tcPr.append(s)


def bordes_tabla(tabla, ver=True):
    tblPr = tabla._tbl.tblPr; b = OxmlElement("w:tblBorders")
    for lado in ("top", "left", "bottom", "right", "insideH", "insideV"):
        e = OxmlElement(f"w:{lado}")
        if ver:
            e.set(qn("w:val"), "single"); e.set(qn("w:sz"), "4"); e.set(qn("w:color"), "808080")
        else:
            e.set(qn("w:val"), "nil")
        b.append(e)
    tblPr.append(b)


def repetir_encabezado(fila):
    trPr = fila._tr.get_or_add_trPr(); e = OxmlElement("w:tblHeader"); e.set(qn("w:val"), "true"); trPr.append(e)


def no_partir(fila):
    trPr = fila._tr.get_or_add_trPr(); e = OxmlElement("w:cantSplit"); e.set(qn("w:val"), "true"); trPr.append(e)


# ---------------------------------------------------------------- documento -------------
doc = Document()
sec = doc.sections[0]
sec.page_width, sec.page_height = Inches(8.5), Inches(11)
for m in ("left_margin", "right_margin", "top_margin", "bottom_margin"):
    setattr(sec, m, Inches(1))
ANCHO = 6.5

st = doc.styles["Normal"]
st.font.name = FUENTE; st.font.size = Pt(11)
st.element.rPr.rFonts.set(qn("w:eastAsia"), FUENTE)
st.paragraph_format.space_after = Pt(6); st.paragraph_format.line_spacing = 1.15
for nivel, tam in ((1, 14), (2, 12), (3, 11)):
    h = doc.styles[f"Heading {nivel}"]
    h.font.name = FUENTE; h.font.size = Pt(tam); h.font.bold = True; h.font.color.rgb = AZUL
    h.element.rPr.rFonts.set(qn("w:asciiTheme"), FUENTE) if False else None
    rf = h.element.rPr.find(qn("w:rFonts"))
    if rf is None:
        rf = OxmlElement("w:rFonts"); h.element.rPr.append(rf)
    for a in ("w:ascii", "w:hAnsi", "w:eastAsia", "w:cs"):
        rf.set(qn(a), FUENTE)
    for a in ("w:asciiTheme", "w:hAnsiTheme", "w:eastAsiaTheme", "w:cstheme"):
        if rf.get(qn(a)) is not None:
            del rf.attrib[qn(a)]
    h.paragraph_format.space_before = Pt(14 if nivel == 1 else 10); h.paragraph_format.space_after = Pt(6)
    h.paragraph_format.keep_with_next = True

CONT = {"fig": 0, "tab": 0, "ec": 0, "num": 0}


def runs(par, texto, size=None, color=None):
    """Texto con **negritas**, *cursivas*, x_{sub} y x^{sup}."""
    for trozo in re.split(r"(\*\*.+?\*\*|\*.+?\*|_\{.+?\}|\^\{.+?\})", texto):
        if not trozo:
            continue
        if trozo.startswith("**"):
            r = par.add_run(trozo[2:-2]); r.bold = True
        elif trozo.startswith("*"):
            r = par.add_run(trozo[1:-1]); r.italic = True
        elif trozo.startswith("_{"):
            r = par.add_run(trozo[2:-1]); r.font.subscript = True
        elif trozo.startswith("^{"):
            r = par.add_run(trozo[2:-1]); r.font.superscript = True
        else:
            r = par.add_run(trozo)
        if size:
            r.font.size = Pt(size)
        if color:
            r.font.color.rgb = color
    return par


def P(texto, al=WD_ALIGN_PARAGRAPH.JUSTIFY, **kw):
    p = doc.add_paragraph(); p.alignment = al; return runs(p, texto, **kw)


def H(texto, nivel=1):
    return doc.add_heading(texto, level=nivel)


def viñeta(texto, estilo="List Bullet"):
    p = doc.add_paragraph(style=estilo); p.alignment = WD_ALIGN_PARAGRAPH.LEFT
    p.paragraph_format.space_after = Pt(2); return runs(p, texto)


def numerada(texto, reiniciar=False):
    if reiniciar:
        CONT["num"] = 0
    CONT["num"] += 1
    p = doc.add_paragraph(); p.alignment = WD_ALIGN_PARAGRAPH.LEFT; p.paragraph_format.space_after = Pt(2)
    p.paragraph_format.left_indent = Inches(0.4); p.paragraph_format.first_line_indent = Inches(-0.3)
    p.paragraph_format.tab_stops.add_tab_stop(Inches(0.4))
    p.add_run(f"{CONT['num']}.	"); return runs(p, texto)


def ecuacion(texto, donde=None):
    CONT["ec"] += 1
    p = doc.add_paragraph(); p.paragraph_format.tab_stops.add_tab_stop(Inches(3.25), WD_TAB_ALIGNMENT.CENTER)
    p.paragraph_format.tab_stops.add_tab_stop(Inches(6.5), WD_TAB_ALIGNMENT.RIGHT)
    p.add_run("\t"); runs(p, texto); p.add_run(f"\t({CONT['ec']})")
    if donde:
        q = P(donde, size=10); q.paragraph_format.left_indent = Inches(0.4)
    return CONT["ec"]


def figura(ruta, titulo, nota="*Nota.* Elaboración propia.", ancho=6.0, alto_max=6.2):
    CONT["fig"] += 1
    w, h = DIMS.get(ruta.replace(os.sep, "/").split("EPANET/3/")[-1], (4, 3))
    if ancho * h / w > alto_max:
        ancho = alto_max * w / h
    p = doc.add_paragraph(); p.paragraph_format.keep_with_next = True; p.paragraph_format.space_after = Pt(0)
    runs(p, f"**Figura {CONT['fig']}**")
    p = doc.add_paragraph(); p.paragraph_format.keep_with_next = True; runs(p, f"*{titulo}*")
    p = doc.add_paragraph(); p.alignment = WD_ALIGN_PARAGRAPH.CENTER; p.paragraph_format.keep_with_next = True
    p.add_run().add_picture(os.path.join(RAIZ, ruta), width=Inches(ancho))
    if nota:
        P(nota, al=WD_ALIGN_PARAGRAPH.LEFT, size=9.5)
    return CONT["fig"]


def figuras_lado(rutas, titulo, nota, alto=3.4):
    CONT["fig"] += 1
    p = doc.add_paragraph(); p.paragraph_format.keep_with_next = True; p.paragraph_format.space_after = Pt(0)
    runs(p, f"**Figura {CONT['fig']}**")
    p = doc.add_paragraph(); p.paragraph_format.keep_with_next = True; runs(p, f"*{titulo}*")
    t = doc.add_table(rows=2, cols=len(rutas)); bordes_tabla(t, False); t.alignment = WD_TABLE_ALIGNMENT.CENTER
    for i, (ruta, sub) in enumerate(rutas):
        w, h = DIMS[ruta.replace("reporte/img/", "fotos_reales/")]
        c = t.cell(0, i); c.paragraphs[0].alignment = WD_ALIGN_PARAGRAPH.CENTER
        c.paragraphs[0].add_run().add_picture(os.path.join(RAIZ, ruta), height=Inches(alto) if w / h < 1.2 else None,
                                               width=None if w / h < 1.2 else Inches(ANCHO / len(rutas) - 0.15))
        c2 = t.cell(1, i); c2.paragraphs[0].alignment = WD_ALIGN_PARAGRAPH.CENTER; runs(c2.paragraphs[0], sub, size=9)
    no_partir(t.rows[0])
    P(nota, al=WD_ALIGN_PARAGRAPH.LEFT, size=9.5)
    return CONT["fig"]


def tabla(enc, filas, anchos, titulo, nota=None, tam=9, alinear=None):
    CONT["tab"] += 1
    p = doc.add_paragraph(); p.paragraph_format.keep_with_next = True; p.paragraph_format.space_after = Pt(0)
    runs(p, f"**Tabla {CONT['tab']}**")
    p = doc.add_paragraph(); p.paragraph_format.keep_with_next = True; runs(p, f"*{titulo}*")
    t = doc.add_table(rows=1 + len(filas), cols=len(enc)); bordes_tabla(t); t.alignment = WD_TABLE_ALIGNMENT.CENTER
    t.autofit = False
    for i, e in enumerate(enc):
        c = t.cell(0, i); sombrear(c, "1F3A5F"); c.vertical_alignment = WD_CELL_VERTICAL_ALIGNMENT.CENTER
        pr = c.paragraphs[0]; pr.alignment = WD_ALIGN_PARAGRAPH.CENTER
        runs(pr, f"**{e}**", size=tam, color=RGBColor(255, 255, 255))
    repetir_encabezado(t.rows[0])
    for j, fila in enumerate(filas, 1):
        no_partir(t.rows[j])
        for i, v in enumerate(fila):
            c = t.cell(j, i); c.vertical_alignment = WD_CELL_VERTICAL_ALIGNMENT.CENTER
            if j % 2 == 0:
                sombrear(c, "EEF2F7")
            pr = c.paragraphs[0]; pr.paragraph_format.space_after = Pt(0); pr.paragraph_format.line_spacing = 1.0
            pr.alignment = (alinear[i] if alinear else (WD_ALIGN_PARAGRAPH.LEFT if i == 0 else WD_ALIGN_PARAGRAPH.CENTER))
            runs(pr, str(v), size=tam)
    for fila in t.rows:
        for i, w in enumerate(anchos):
            fila.cells[i].width = Inches(w)
    if len(filas) <= 18:
        for fila in t.rows[:-1]:
            for c in fila.cells:
                for pr in c.paragraphs:
                    pr.paragraph_format.keep_with_next = True
    if nota:
        q = P(nota, al=WD_ALIGN_PARAGRAPH.LEFT, size=9.5); q.paragraph_format.space_before = Pt(3)
    else:
        doc.add_paragraph().paragraph_format.space_after = Pt(2)
    return CONT["tab"]


def salto():
    doc.add_paragraph().add_run().add_break(WD_BREAK.PAGE)


def leer_csv(nombre):
    with open(os.path.join(RAIZ, nombre), encoding="utf8") as fh:
        return list(csv.DictReader(fh))


# ================================================================= PORTADA ==================
for t, tam, neg in ((PORTADA["institucion"], 15, True), (PORTADA["escuela"], 12, False), (PORTADA["campus"], 12, False)):
    p = doc.add_paragraph(); p.alignment = WD_ALIGN_PARAGRAPH.CENTER; r = p.add_run(t); r.font.size = Pt(tam); r.bold = neg
p = doc.add_paragraph(); p.paragraph_format.space_before = Pt(18); p.alignment = WD_ALIGN_PARAGRAPH.CENTER
r = p.add_run(PORTADA["materia"]); r.font.size = Pt(12)
p = doc.add_paragraph(); p.paragraph_format.space_before = Pt(40); p.alignment = WD_ALIGN_PARAGRAPH.CENTER
r = p.add_run(PORTADA["titulo"]); r.bold = True; r.font.size = Pt(18); r.font.color.rgb = AZUL
p = doc.add_paragraph(); p.alignment = WD_ALIGN_PARAGRAPH.CENTER
r = p.add_run(PORTADA["subtitulo"]); r.italic = True; r.font.size = Pt(12)
p = doc.add_paragraph(); p.paragraph_format.space_before = Pt(36); p.alignment = WD_ALIGN_PARAGRAPH.CENTER
r = p.add_run("Integrantes del equipo"); r.bold = True
t = doc.add_table(rows=1 + len(PORTADA["integrantes"]), cols=2); bordes_tabla(t); t.alignment = WD_TABLE_ALIGNMENT.CENTER
for i, e in enumerate(("Nombre", "Matrícula")):
    c = t.cell(0, i); sombrear(c, "1F3A5F"); c.paragraphs[0].alignment = WD_ALIGN_PARAGRAPH.CENTER
    runs(c.paragraphs[0], f"**{e}**", color=RGBColor(255, 255, 255))
for j, (n, m) in enumerate(PORTADA["integrantes"], 1):
    t.cell(j, 0).text = n; t.cell(j, 1).text = m; t.cell(j, 1).paragraphs[0].alignment = WD_ALIGN_PARAGRAPH.CENTER
for fila in t.rows:
    fila.cells[0].width = Inches(3.6); fila.cells[1].width = Inches(1.6)
for t_, neg in ((f"Profesor(a): {PORTADA['profesor']}", False), (PORTADA["lugar_fecha"], False)):
    p = doc.add_paragraph(); p.paragraph_format.space_before = Pt(24); p.alignment = WD_ALIGN_PARAGRAPH.CENTER
    p.add_run(t_)

# ================================================================= ÍNDICE ===================
doc.add_section(WD_SECTION.NEW_PAGE)
p = doc.add_paragraph(); r = p.add_run("Índice"); r.bold = True; r.font.size = Pt(14); r.font.color.rgb = AZUL
campo(doc.add_paragraph(), 'TOC \\o "1-2" \\h \\z \\u')
p = doc.add_paragraph(); p.paragraph_format.space_before = Pt(12)
r = p.add_run("Índice de figuras"); r.bold = True; r.font.size = Pt(12); r.font.color.rgb = AZUL
P("Las figuras y tablas se numeran en orden de aparición (formato APA 7.ª ed.).", size=9.5)

# pie de página con número (secciones 2 en adelante)
s2 = doc.sections[1]; s2.footer.is_linked_to_previous = False
fp = s2.footer.paragraphs[0]; fp.alignment = WD_ALIGN_PARAGRAPH.CENTER; campo(fp, "PAGE", "1")
doc.sections[0].footer.is_linked_to_previous = False
salto()

# ================================================================= RESUMEN ==================
Q = res["Q_total_Lmin"]; Pmin, Pmax = res["P_min"], res["P_max"]
H("Resumen", 1)
P(f"Se diseñó, modeló e implementó un sistema de riego automatizado por aspersión para un huerto elevado (cajón de 1 × 1 m). "
  f"El agua sale del tinaco existente, pasa por la instalación previa (válvula de bola, check y bajada de Tuboplus) y es impulsada "
  f"por una bomba de diafragma de 12 V; después atraviesa un caudalímetro YF-S201 y una electroválvula normalmente cerrada, recorre "
  f"la línea principal de Tuboplus de 20 mm, sube verticalmente hasta 1.52 m y se reparte en una cruz hacia **3 líneas paralelas de "
  f"manguera con 3 aspersores cada una (9 aspersores)**. La red se modeló en EPANET 2.2 (unidades LPS, fórmula de Darcy-Weisbach) con "
  f"43 nodos y 43 enlaces, y se verificó con cálculo manual y con otros tres motores (WNTR, EPyT y el servidor MCP de EPANET). Con el "
  f"caudal nominal provisional de 30 L/h por aspersor (Q = {Q:.2f} L/min), la presión en los aspersores resultó de {Pmin:.2f}–{Pmax:.2f} m "
  f"(≈ {Pmin * 0.0981:.2f} bar), con una relación Pmin/Pmax de {res['uniformidad_hidraulica_presion_PminPmax']:.4f}; la velocidad en la "
  f"línea principal fue de {res['V_principal']:.2f} m/s. Las presiones son preliminares porque el fabricante no publica la curva "
  f"carga-caudal de la bomba. El sistema se armó en sitio y funcionó; el control con ESP32 mide el volumen con el YF-S201 (450 pulsos/L) "
  f"y apaga la bomba al completar 5 L por riego. Se listan las mediciones físicas pendientes con las que se actualizará el modelo.")
p = P("**Palabras clave:** EPANET, riego por aspersión, Darcy-Weisbach, bomba de diafragma, ESP32, Tuboplus.")

# ================================================================= 1 INTRODUCCIÓN ===========
H("1. Introducción", 1)
P("El riego manual de un huerto escolar depende de la disponibilidad de las personas y suele aplicar volúmenes irregulares. "
  "Automatizarlo exige resolver dos problemas a la vez: uno hidráulico (llevar el agua desde el tinaco hasta los aspersores con "
  "presión y caudal suficientes) y otro de control (decidir cuándo regar y cuánta agua aplicar). Este reporte documenta ambos para "
  "el huerto elevado del reto.")
P("La parte hidráulica se resolvió con EPANET 2.2, el programa de la Agencia de Protección Ambiental de Estados Unidos (EPA) para "
  "simular redes a presión (Rossman et al., 2020). Aunque EPANET suele usarse en redes municipales, sus ecuaciones son las mismas para "
  "una red pequeña: conservación de masa en los nodos y de energía en los tramos, con pérdidas por fricción y por accesorios. La parte "
  "de control usa un microcontrolador ESP32 que cuenta los pulsos del caudalímetro y gobierna la bomba (Espressif Systems, 2024).")
P("El documento describe el sistema construido, los datos y supuestos del modelo, los cálculos hidráulicos tramo por tramo, los "
  "resultados de EPANET, el análisis de sensibilidad, la lógica de control, la lista de materiales y las mediciones que faltan para "
  "cerrar el modelo con datos reales.")

# ================================================================= 2 OBJETIVOS ==============
H("2. Objetivos", 1)
H("2.1 Objetivo general", 2)
P("Diseñar, modelar en EPANET e implementar un sistema de riego por aspersión automatizado que distribuya agua del tinaco existente "
  "a 9 aspersores sobre un cajón de cultivo de 1 × 1 m, controlando el volumen aplicado con un sensor de flujo y un microcontrolador.")
H("2.2 Objetivos específicos", 2)
for t in ("Definir el trazado físico (diseño principal con subida vertical) y todas las conexiones desde el tinaco hasta los aspersores.",
          "Construir el modelo hidráulico en EPANET 2.2 con datos oficiales de la tubería y de los accesorios.",
          "Calcular a mano velocidades, número de Reynolds, factores de fricción y pérdidas, y compararlos con EPANET.",
          "Evaluar la presión en los 9 aspersores, el punto de operación de la bomba y la sensibilidad a los datos inciertos.",
          "Describir el sistema de control por volumen con ESP32 y caudalímetro YF-S201.",
          "Identificar las mediciones físicas necesarias para validar y actualizar el modelo."):
    viñeta(t)

# ================================================================= 3 MARCO TEÓRICO ===========
H("3. Marco teórico", 1)
H("3.1 Ecuación de la energía", 2)
P("Entre dos puntos 1 y 2 de una tubería con una bomba intermedia, la ecuación de la energía (Bernoulli extendida) es "
  "(Çengel & Cimbala, 2018; Mott & Untener, 2015):")
ecuacion("z_{1} + p_{1}/γ + V_{1}^{2}/2g + h_{B} = z_{2} + p_{2}/γ + V_{2}^{2}/2g + h_{f} + h_{m}",
         "donde z es la elevación (m), p/γ la carga de presión (m), V la velocidad (m/s), h_{B} la carga que aporta la bomba, "
         "h_{f} las pérdidas por fricción y h_{m} las pérdidas menores (accesorios). EPANET trabaja con la carga piezométrica H = z + p/γ.")
H("3.2 Caudal, velocidad y número de Reynolds", 2)
ecuacion("V = Q / A = 4Q / (πD^{2})")
ecuacion("Re = V·D / ν", "con ν = 1.0 × 10^{-6} m²/s (agua a 20 °C). Re < 2000: laminar; 2000–4000: transición; > 4000: turbulento.")
H("3.3 Pérdidas por fricción: Darcy-Weisbach", 2)
ecuacion("h_{f} = f · (L/D) · V^{2}/2g")
P("En régimen laminar f = 64/Re. En régimen turbulento f se obtiene de la ecuación de Colebrook (1939), que EPANET aproxima con la "
  "fórmula explícita de Swamee y Jain (1976):")
ecuacion("1/√f = −2 log_{10}( ε/(3.7D) + 2.51/(Re√f) )",
         "con rugosidad absoluta ε = 0.007 mm para PP-R Tuboplus (Rotoplas, 2017). Como comparación se usó Hazen-Williams con C = 150.")
H("3.4 Pérdidas menores", 2)
ecuacion("h_{m} = K · V^{2}/2g",
         "K se toma de la Tabla 10 del Manual Técnico Tuboplus para codos, conectores y tees (Rotoplas, 2017) y de Crane Co. (2010) "
         "para válvulas. Para la electroválvula se usa el coeficiente de flujo K_{v}: Δp[bar] = (Q[m³/h]/K_{v})^{2} (IEC, 2011).")
H("3.5 Bomba y punto de operación", 2)
P("La bomba entrega una carga h_{B} que disminuye al aumentar el caudal (curva carga-caudal). El punto de operación es el caudal "
  "con el que la carga de la bomba iguala la carga que exige el sistema. En este proyecto los aspersores se modelan con **demanda "
  "fija** (caudal impuesto), así que EPANET calcula qué carga entrega la bomba a ese caudal y con ello la presión en cada aspersor.")
H("3.6 EPANET 2.2", 2)
P("EPANET resuelve simultáneamente la continuidad en nodos y la energía en enlaces con el método del gradiente global (Todini & "
  "Pilati, 1988). Representa tinacos como *reservoirs* o *tanks*, tuberías como *pipes* (con K menor), bombas con su curva, válvulas "
  "check como tuberías CV y consumos como demandas en nodos (Rossman et al., 2020).")
H("3.7 Sensor de flujo YF-S201", 2)
P("El YF-S201 es un caudalímetro de turbina con sensor de efecto Hall. Su frecuencia de salida es F = 7.5·Q (F en Hz, Q en L/min), "
  "equivalente a 450 pulsos por litro, para un rango de 1 a 30 L/min (Handson Technology, s. f.).")

# ================================================================= 4 DESCRIPCIÓN ============
H("4. Descripción del sistema", 1)
H("4.1 Sitio e instalación construida", 2)
P("El sistema se instaló junto al edificio, alimentado por el tinaco negro ubicado a la derecha (Figura 1). El cajón de cultivo de "
  "1 × 1 m tiene un marco de madera que sostiene las líneas a 1.00 m sobre el borde superior del cajón. La subida de Tuboplus llega "
  "a la cruz y de ella salen las 3 mangueras negras con 3 aspersores rojos cada una (Figura 2). Las cajas grises del piso solo "
  "protegen la electrónica. **El sistema ya está armado y se probó en funcionamiento.**")
figura("reporte/img/F01_vista_general_tinaco_cajon.jpg", "Vista general: tinaco de alimentación (derecha), cajón y marco con las líneas de aspersión",
       "*Nota.* Fotografía tomada por el equipo, 2026.", ancho=4.0, alto_max=5.0)
figuras_lado([("reporte/img/F02_cajon_subida_y_cruz.jpg", "a) Subida de Tuboplus, cruz y laterales"),
              ("reporte/img/F03_lineas_y_aspersores.jpg", "b) Tres mangueras con 3 aspersores cada una")],
             "Detalle de la distribución sobre el cajón", "*Nota.* Fotografías tomadas por el equipo, 2026.", alto=3.6)

H("4.2 Componentes", 2)
P("La Tabla 1 resume los componentes. La bomba es de diafragma, autocebante, con presostato que la apaga al cerrarse el flujo "
  "(Figura 3). El dato de 0.9 MPa (130 psi) de la placa es la **presión de corte del presostato**, con caudal prácticamente nulo; "
  "no es la presión a 6 L/min (La Electrónica, s. f.).")
comp = [("Tinaco (existente)", "Agua a +1.19 m; salida 1/2\" a +0.265 m", "Reserva de agua"),
        ("Válvula de bola 1/2\" (existente)", "Paso completo", "Cierre manual"),
        ("Válvula check 1/2\" (existente)", "Columpio", "Evita retorno al tinaco"),
        ("Tubo Tuboplus PP-R clase 16", "20 mm, DI 14.40 mm, SDR 7.4", "Línea principal, subida y brazos"),
        ("Codos 90°, cruz, conectores, uniones mixtas Tuboplus", "20 mm; 20 × 1/2\"", "Cambios de dirección y transiciones"),
        ("Bomba de diafragma GOOD PUMPS", "12 V, 6 A, 72 W, 6 L/min máx., corte 0.9 MPa", "Impulsión"),
        ("Caudalímetro YF-S201", "G1/2, DI 11 mm, 1–30 L/min, 450 pulsos/L", "Medición de volumen"),
        ("Electroválvula NC 12 V DC", "1/2\"", "Apertura/cierre del riego"),
        ("Manguera negra", "DI ≈ 12 mm (por medir), 3 tramos ≈ 0.9 m", "Laterales"),
        ("Aspersores regulables (9)", "≈ 70 L/h máx.; nominal del modelo 30 L/h", "Riego"),
        ("ESP32 + relevador", "GPIO2 (bomba), GPIO4 (pulsos)", "Control por volumen")]
tabla(["Componente", "Especificación", "Función"], comp, [2.4, 2.4, 1.7], "Componentes principales del sistema",
      "*Nota.* Datos de placa, fichas técnicas y Rotoplas (2017). Elaboración propia.")
figuras_lado([("reporte/img/F04_bomba_placa.jpg", "a) Bomba y placa de datos"),
              ("reporte/img/F06_caja_bomba_etiqueta_SKU.jpg", "b) Etiqueta: 130 psi, 6 L/min, 12 V, 72 W"),
              ("reporte/img/F08_manguera_negra.jpg", "c) Manguera negra de los laterales")],
             "Bomba de diafragma y manguera utilizadas", "*Nota.* Fotografías tomadas por el equipo, 2026.", alto=2.6)

H("4.3 Recorrido y conexiones (tinaco → aspersores)", 2)
P("El recorrido completo, en el orden en que circula el agua, es el siguiente (Figuras 4 a 6):")
P("**Instalación existente (no se modificó):**", al=WD_ALIGN_PARAGRAPH.LEFT)
CONT["num"] = 0
for t in ("Tinaco → niple de salida 1/2\".", "Válvula de bola manual 1/2\" (abierta durante el riego).", "Válvula check 1/2\".",
          "Conector y tramo corto de Tuboplus 20 mm → T de Tuboplus.", "Bajada vertical de Tuboplus hasta z ≈ 0.08 m."):
    numerada(t)
P("**Equipos y línea nueva:**", al=WD_ALIGN_PARAGRAPH.LEFT)
for t in ("Codo 90° al pie de la bajada → tramo de Tuboplus → unión mixta 20 × 1/2\".",
          "Adaptación 1/2\" → puerto de la bomba (≈ 3/8\"; tipo de rosca por confirmar).",
          "**Bomba** → adaptación → unión mixta 20 × 1/2\" → niple de Tuboplus.",
          "Conector hembra 20 × 1/2\" → **caudalímetro YF-S201** → conector hembra → niple → conector hembra.",
          "**Electroválvula NC** → conector hembra 20 × 1/2\".",
          "Línea principal de Tuboplus hasta el cajón (≈ 2.74 m).",
          "Codo 90° → **subida vertical** de Tuboplus (0.08 → 1.52 m, ≈ 1.44 m) → codo 90°.",
          "Tramo corto horizontal de Tuboplus → **cruz** Tuboplus (z = 1.52 m)."):
    numerada(t)
P("**Salidas de la cruz (3 líneas):**", al=WD_ALIGN_PARAGRAPH.LEFT)
for t in ("**Línea 2 (centro):** salida recta → tubo → unión (conector hembra 20 × 1/2\") → espiga → manguera.",
          "**Líneas 1 y 3 (lados):** salida lateral → tubo (brazo ≈ 0.33 m) → codo 90° → tubo → unión → espiga → manguera.",
          "En cada manguera: aspersor a ≈ 0.145 m, segundo a 0.33 m, tercero a 0.33 m y tapón final; 3 × 3 = 9 aspersores."):
    viñeta(t)
figura("reporte/figuras/fig_bloques.png", "Diagrama de bloques del recorrido del agua")
figura("reporte/figuras/fig_elevacion.png", "Esquema en elevación del diseño construido (subida vertical)",
       "*Nota.* Elaboración propia. Longitudes estimadas, pendientes de medición (sección 11).")
figura("reporte/figuras/fig_planta.png", "Vista en planta del cajón: 3 líneas × 3 aspersores", ancho=4.2)
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
